oomlout/oomlout_oobb_part_motor_gearbox_cycloidal_version_5/releases/version_8/README.md

# Version 8 — sealed

Preserves both native 20:1 and compact 10:1 presets, the nine printed parts, three-piece casing, full-depth OOBB tabs, recessed socket-cap clamps and configurable guide screws/spacers.

The archive contains the source, both complete parts folders, populate metadata, navigation pointers and accepted CAD evidence (solidcraft/evidence/v8_three_piece.zip). Every archived file was verified by SHA-256. release.json also protects the frozen catalogue files in place. The master here is a frozen inspection copy; edit the root gearbox_controls.solidcraft or V9 variant masters for new work.

Six native configurations were checked; both presets have STEP/STL, native health, save/reopen, motion, sampling and hardware/access evidence. Existing acceptance policy is unchanged. Physical printing and load testing remain outstanding.
