oomlout/oomlout_oobb_part_motor_gearbox_cycloidal_version_5/parts/oobb_part_motor_gearbox_cycloidal_version_9_35_to_1_reduction/HARDWARE.md

# Hardware

| Item | Quantity |
|---|---:|
| 6808 bearing (40 × 52 × 7 mm) | 2 |
| 6702 bearing (15 × 21 × 4 mm) | 2 |
| 6701 bearing (12 × 18 × 4 mm) | 1 |
| M3 × 25 socket-cap guide screw + M3 nut | 6 |
| M3 × 25 socket-cap standoff screw + M3 nut | 3 |
| M3 × 20 socket-cap casing screw + M3 nut | 4 |
| M3 × 6 countersunk NEMA17 mounting screw | 4 |
| M3 × 4 socket-cap hub joining screw + M3 nut | 1 |
| M3 × 8 grub screw + M3 nut | 1 |
| M6 nuts for selected output mounting holes | Up to 12, optional |

Lengths are nominal under-head dimensions except countersunk screws, which include the head. The base grub screw is tightened before fitting the motor plate. The native exploded view shows printed parts; purchased hardware is listed here. Mounting screws for an attached OOBB structure depend on that structure. Physical fit/load testing remains necessary.
