oomlout/oomlout_oobb_part_motor_gearbox_cycloidal_version_5/cycloidal_explorer/dist/cycloidal-examples.pdf

OOBB / MECHANISM STUDIES | V05 / GEOMETRY LAB

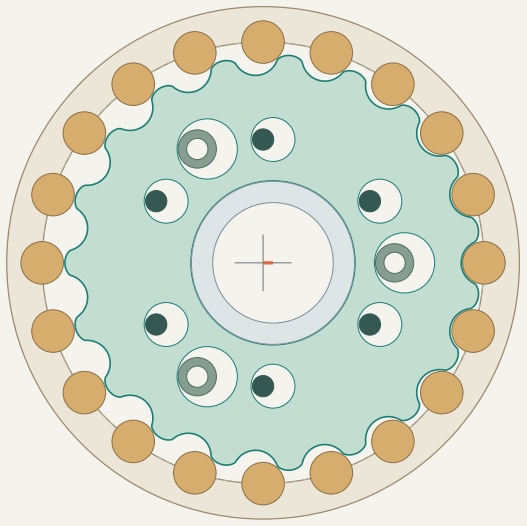
[picture p1: figure]

Cycloidal V5 | 26 October 2026 | Dimensions in mm | DESIGN STUDY / 01

# 20:1 / Current V5

The active 20:1 design: 3 mm printed contacts and 1.4 mm eccentricity.

6810

50 x 65 x 7 mm

Casing diameter 72.30 | Outside diameter 65.00

Bore diameter 50.00

Pitch diameter 62.30 | 19 disc lobes
Ring contacts / disc lobes / output direction | 20 / 19 / same as input
Pitch radius / contact radius / eccentricity | 31.15 / 3.00 / 1.40
Radial profile clearance / casing wall | 0.20 / 2.00
Disc root / tip diameter | 53.10 / 58.70
Disc swept envelope / casing diameter | 61.50 / 72.30
Guide holes (6) / guide pitch circle | 6.20 / 34.80
Standoff holes (3) / standoff pitch circle | 8.50 / 37.10
Disc thickness / gap / bearing-disc stack only | 5.00 / 0.50 / 24.50
Minimum convex radius / offset used | 3.213 / 3.200

8/8 screening checks pass

The explorer checks radial envelopes, undercut, contact attachment, orbit-hole webs, casing-lip passage and eccentric-bearing retention. Explorations are not full CAD-validated assemblies.

Current V5 reference: 32 mm overall height above the motor face; casing depth 26.6 mm; mounting plate 74 mm across. These heights are not extrapolated to changed designs.

50 mm check bar. Diagrams 1:1 on A4 at 100% / Actual size.

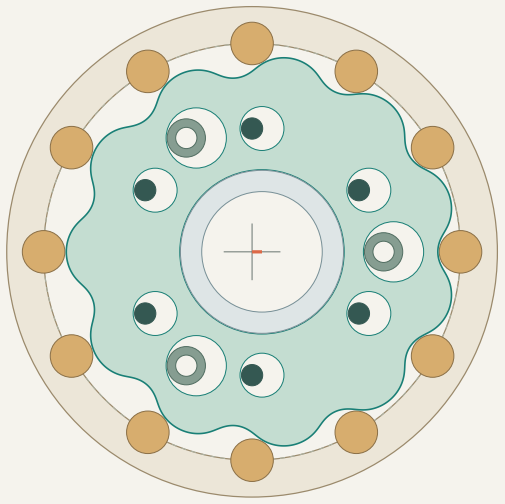
[picture p2: figure]

Cycloidal V5 | 26 October 2026 | Dimensions in mm | DESIGN STUDY / 02

# 12:1 / 12:1 exploration

Fewer, broader lobes with the same contacts and orbit. V5 radial interfaces retained.

6810

50 x 65 x 7 mm

Casing diameter 69.20 | Outside diameter 65.00

Bore diameter 50.00

Pitch diameter 58.80 | 11 disc lobes
Ring contacts / disc lobes / output direction | 12 / 11 / same as input
Pitch radius / contact radius / eccentricity | 29.40 / 3.00 / 1.40
Radial profile clearance / casing wall | 0.20 / 2.00
Disc root / tip diameter | 49.60 / 55.20
Disc swept envelope / casing diameter | 58.00 / 69.20
Guide holes (6) / guide pitch circle | 6.20 / 34.80
Standoff holes (3) / standoff pitch circle | 8.50 / 37.10
Disc thickness / gap / bearing-disc stack only | 5.00 / 0.50 / 24.50
Minimum convex radius / offset used | 8.871 / 3.200

8/8 screening checks pass

The explorer checks radial envelopes, undercut, contact attachment, orbit-hole webs, casing-lip passage and eccentric-bearing retention. Explorations are not full CAD-validated assemblies.

Retains the fixed V5 radial interfaces and 6810 end bearings. Recalculate the axial stack and run the native CAD, assembly and motion checks before making parts.

50 mm check bar. Diagrams 1:1 on A4 at 100% / Actual size.

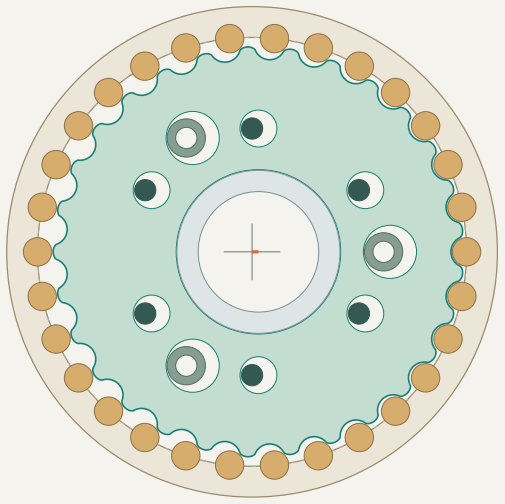
[picture p3: figure]

Cycloidal V5 | 26 October 2026 | Dimensions in mm | DESIGN STUDY / 03

# 30:1 / 30:1 exploration

A smaller orbit and 2 mm contacts keep the higher contact count compact.

6810

50 x 65 x 7 mm

Casing diameter 69.20 | Outside diameter 65.00

Bore diameter 50.00

Pitch diameter 60.50 | 29 disc lobes
Ring contacts / disc lobes / output direction | 30 / 29 / same as input
Pitch radius / contact radius / eccentricity | 30.25 / 2.00 / 0.90
Radial profile clearance / casing wall | 0.20 / 2.00
Disc root / tip diameter | 54.30 / 57.90
Disc swept envelope / casing diameter | 59.70 / 69.20
Guide holes (6) / guide pitch circle | 5.20 / 34.80
Standoff holes (3) / standoff pitch circle | 7.50 / 37.10
Disc thickness / gap / bearing-disc stack only | 5.00 / 0.50 / 24.50
Minimum convex radius / offset used | 2.211 / 2.200

8/8 screening checks pass

The explorer checks radial envelopes, undercut, contact attachment, orbit-hole webs, casing-lip passage and eccentric-bearing retention. Explorations are not full CAD-validated assemblies.

Retains the fixed V5 radial interfaces and 6810 end bearings. Recalculate the axial stack and run the native CAD, assembly and motion checks before making parts.

50 mm check bar. Diagrams 1:1 on A4 at 100% / Actual size.

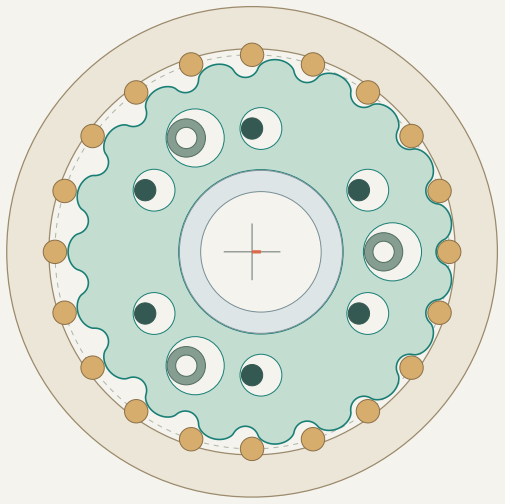
[picture p4: figure]

Cycloidal V5 | 26 October 2026 | Dimensions in mm | DESIGN STUDY / 04

# 20:1 / Smaller-contact study

A 20:1 study inspired by the earlier 1.65 mm contact / 1.25 mm orbit iterations.

6810

50 x 65 x 7 mm

Casing diameter 69.20 | Outside diameter 65.00

Bore diameter 50.00

Pitch diameter 55.60 | 19 disc lobes
Ring contacts / disc lobes / output direction | 20 / 19 / same as input
Pitch radius / contact radius / eccentricity | 27.80 / 1.65 / 1.25
Radial profile clearance / casing wall | 0.20 / 2.00
Disc root / tip diameter | 49.40 / 54.40
Disc swept envelope / casing diameter | 56.90 / 69.20
Guide holes (6) / guide pitch circle | 5.90 / 34.80
Standoff holes (3) / standoff pitch circle | 8.20 / 37.10
Disc thickness / gap / bearing-disc stack only | 5.00 / 0.50 / 24.50
Minimum convex radius / offset used | 2.862 / 1.850

8/8 screening checks pass

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

Retains the fixed V5 radial interfaces and 6810 end bearings. Recalculate the axial stack and run the native CAD, assembly and motion checks before making parts.

50 mm check bar. Diagrams 1:1 on A4 at 100% / Actual size.

Cycloidal V5 | 26 October 2026 | Dimensions in mm | PROJECT LESSONS / 05

# Why the old pitch failed

The project regression captures an important failure: increasing the contact radius without increasing the pitch radius creates an undercut profile.

Same inputs in both studies | 20 contacts / e 1.40 / r 3.00 / clearance 0.20
Old pitch radius / current pitch radius | 30.15 / 31.15
Old minimum convex radius | 2.631624
Required inward offset | 3.200000
Old undercut margin | -0.568376 - rejected
Current minimum convex radius | 3.212642
Current undercut margin | 0.012642 - passes

### 01 / The ratio belongs to the output member

The V5 discs are prevented from spinning by fixed guides. They orbit on opposed eccentrics while the casing rotates in the input direction. N contacts and N-1 disc lobes give N:1 casing reduction. A fixed-ring, rotating-disc arrangement has a different ratio and direction.

### 02 / Contact radius is not rotor radius

The adjustable lobe radius is the radius of each circular contact in the casing. Current contacts are solid printed features. A future M3 axle needs a 6 mm outside-diameter roller or sleeve to reproduce a 3 mm contact radius.

### 03 / Bearings occupy a different axial region

6810 means 50 mm bore, 65 mm outside diameter, 7 mm width. Two end bearings capture the casing. The disc plane lies between them. Guide holes are 3 + 2e + 0.40 mm; standoff holes are 5.4 + 2e + 0.30 mm. More eccentricity takes material out of both webs.

### 04 / Geometry is the first gate

A passing radial study does not establish load capacity, backlash, wear or print fit. The current underside needs slicer supports. Test the shared fit coupons and smooth guide surfaces, and run the full native CAD and motion validation for any changed design.

Source trace

Repository: README.md; working_oomp_populate.py; gearbox_native/cycloid_equation.py, captured.py, simple.py and interfaces.py; tests/test_native_three_mm_lobes.py. All four examples use the same geometry calculation as the HTML explorer.

Bearing reference: NSK 6810 product dimensions (50 x 65 x 7 mm). (https://www.nsk.com/engineering/products/bearings/ball-bearings/deep-groove-ball-bearings/single-row-deep-groove-ball-bearings/6810-apn.html)
