oomlout/oomlout_oobb_part_motor_gearbox_cycloidal_version_5/navigation_oobb/oobb/part/motor_gearbox/cycloidal/version_9/35_to_1_reduction/README.md

# Native V9 — 35:1

[Parts and editing instructions](../../../../../../../parts/oobb_part_motor_gearbox_cycloidal_version_9_35_to_1_reduction/README.md)
