oomlout/oomlout_oobb_part_motor_gearbox_cycloidal_version_5/releases/version_7/README.md

# Version 7 — sealed

Preserves the native parametric gearbox, 40 casing-bearing options and automatic odd OOBB mounting footprints. The current native master, assembled/exploded/print exports, source, shared helper component sources and accepted JSON verification records are in version_7.zip. Each archive entry is SHA-256 checked. See evidence_index.json for the archived verification paths. Historical inherited layouts and renders remain protected in the V7 catalogue and earlier releases.

The frozen master is in [the sealed V7 parts folder](../../parts/oobb_part_motor_gearbox_cycloidal_version_7_20_to_1_reduction/gearbox_controls.solidcraft). The project-root master continues as V8. No geometry or acceptance-policy changes were made. Twelve targeted tests passed. Physical printing/load testing remains outstanding.
