oomlout/oomlout_oobb_part_motor_gearbox_cycloidal_version_5/navigation_oobb/oobb/part/motor_gearbox/cycloidal/version_4/20_to_1_reduction/part_names.md

# Version 4 part names

| Name | File / hardware |
| --- | --- |
| Motor faceplate | motor_mount |
| Rear pin carrier | pin_rear |
| Front pin carrier | pin_front |
| Front bearing hub | front_bearing_hub |
| Output cover | output_cover |
| Disc A lower | rotor_a_lower |
| Disc A upper | rotor_a_upper |
| Disc B lower | rotor_b_lower |
| Disc B upper | rotor_b_upper |
| Output lobe ring | output_casing |
| Output casing base | output_base |
| Lower wiggle shaft | eccentric_hub_lower |
| Coupling drive plate | coupling_drive |
| Upper wiggle shaft | eccentric_hub_upper |
| Coupling nut collar | coupling_collar |
| Casing bearings | 2 x 6810 / 50 x 65 x 7 |
| Eccentric bearings | 2 x 6704 / 20 x 27 x 4 |
| Front shaft bearing | 6704 / 20 x 27 x 4 |
| Disc bearing rows | 12 x 6700 / 10 x 15 x 4 |
| Fixed guide bolts | 6 x M6 x 40 + nuts |
| Carrier spacers | 3 steel tubes / 6 OD x 3.2 ID x 15.5 |
| Disc screws | 6 x M3 x 6 countersunk + nuts |
| Hub joining bolt | M6 x 35 + captive M6 nut |
| Flange coupling | M5 bore / flange UP at 24 mm |
| Flange screws | 2 x M3 x 12 + side-loaded nuts |
| Motor screws | 4 x M3 x 6 countersunk |
| NEMA 17 motor | 5 mm shaft |
| Support fasteners | 3 x M3x25 rear; 3 x M3x25 posts; 3 x M3x16 hub |
| Casing screws | 4 x M3x35 socket caps; clamp cover / ring / base |
