oomlout/oomlout_oobb_part_motor_gearbox_cycloidal_version_5/parts/oobb_part_motor_gearbox_cycloidal_version_6_20_to_1_reduction_configuration_3d9262f6/solidcraft_renders/true/with_hardware/exploded_raw.png

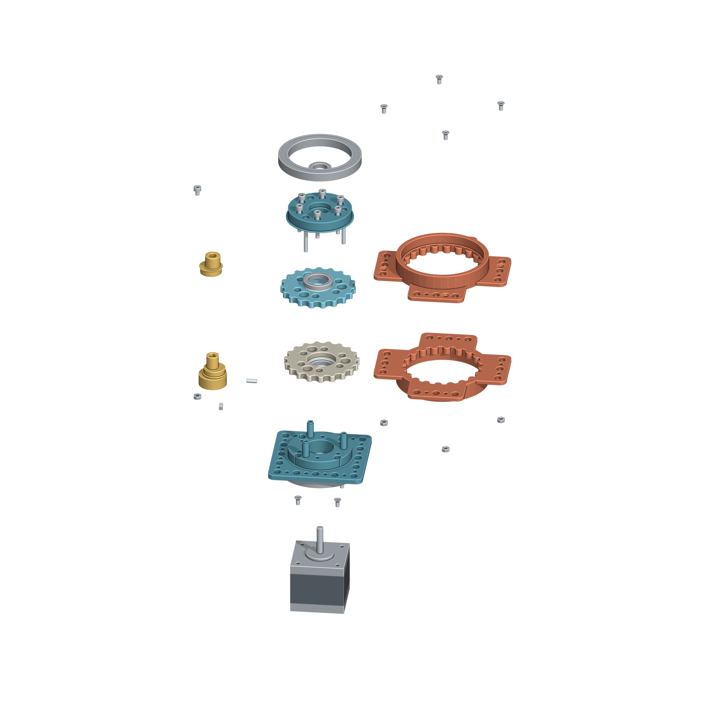
parts/oobb_part_motor_gearbox_cycloidal_version_6_20_to_1_reduction_configuration_3d9262f6/solidcraft_renders/true/with_hardware/exploded_raw.png
