oomlout/oomlout_oobb_part_motor_gearbox_cycloidal_version_5/parts/oobb_part_motor_gearbox_cycloidal_version_9_35_to_1_reduction/README.md

# Native V9 — 35:1

Edit [gearbox_controls.solidcraft](gearbox_controls.solidcraft) in SolidCraft's
Parameters menu. [Editing instructions](EDITING_PARAMETERS.md) explain the
controls and print orientations. This preset uses the same feature graph as
the other V9 presets, with exposed parameter overrides only.

| Dimension | Value |
|---|---:|
| Contact radius | 1.5 mm |
| Eccentricity | 0.7 mm |
| Casing bearing | 6808 |
| Minimum circular casing envelope | 62.8 mm |
| OOBB grid | 5 × 5 |
| Tab footprint | 74 × 74 mm |
| Guide screws | 6 × M3 × 25 mm |
| Casing joining screws | 4 × M3 socket cap × 20 mm |

[Assembled](true.solidcraft) · [Exploded](exploded.solidcraft) ·
[Print layout](3dpr.solidcraft) · [Print STL](3dpr.stl)

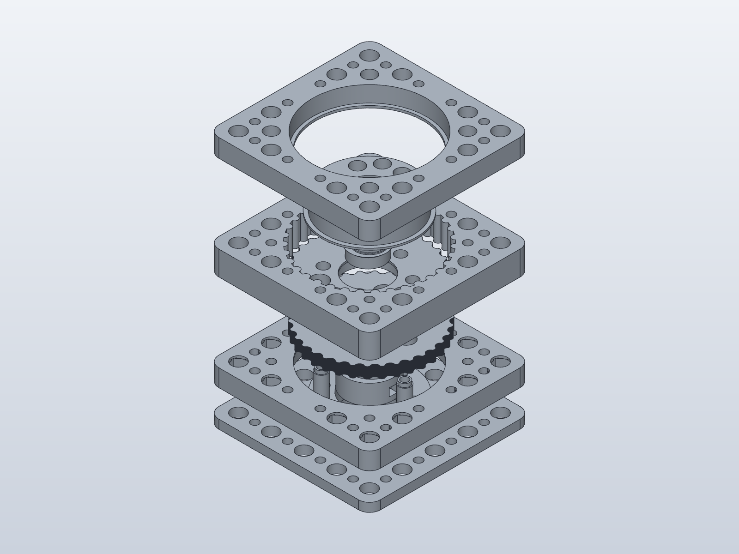
[picture p23: parts/oobb_part_motor_gearbox_cycloidal_version_9_35_to_1_reduction/exploded.png]
Exploded printed components


Individual print-oriented STEP/STL files are in `native_parts/`. The three
casing pieces print separately on their flat split/end faces. These view files
are independent snapshots. Native geometry and hardware clearance have been
checked; physical printing and load testing are still needed.

[Hardware for this published preset](HARDWARE.md)
