oomlout/oomlout_oobb_part_motor_gearbox_cycloidal_version_5/parts/oobb_part_motor_gearbox_cycloidal_version_7_20_to_1_reduction/README.md

# Native V7 snapshots

Start with [Editing the gearbox parameters](EDITING_PARAMETERS.md) for step-by-step instructions and generating assembled, exploded and print outputs from one master.

The working master is [../../gearbox_controls.solidcraft](../../gearbox_controls.solidcraft). Change its favourite parameters inside SolidCraft; no regeneration action is needed.

See [the parameter guide](../../NATIVE_V7.md) and [verification index](../../solidcraft/native_v7.json).

Local gearbox_controls.solidcraft, true.solidcraft, 3dpr.solidcraft and exploded.solidcraft are initial self-contained snapshots, not synchronized copies of the master. Individual current STEP/STL files are in native_parts/. The solidcraft/true and solidcraft/3dpr source documents and fits/ are inherited V6 evidence, not dependencies of the new master.
