oomlout/oomlout_oobb_part_motor_gearbox_cycloidal_version_5/parts/oobb_part_motor_gearbox_cycloidal_version_7_20_to_1_reduction/VERSION_7_DEVELOPMENT.md

See [the current V7 development record](../../VERSION_7_DEVELOPMENT.md).
