oomlout/oomlout_oobb_part_motor_gearbox_cycloidal_version_5/parts/oobb_part_motor_gearbox_cycloidal_version_6_16_to_1_reduction_configuration_805810a8/fits/3dpr/fit_6701_shaft.png

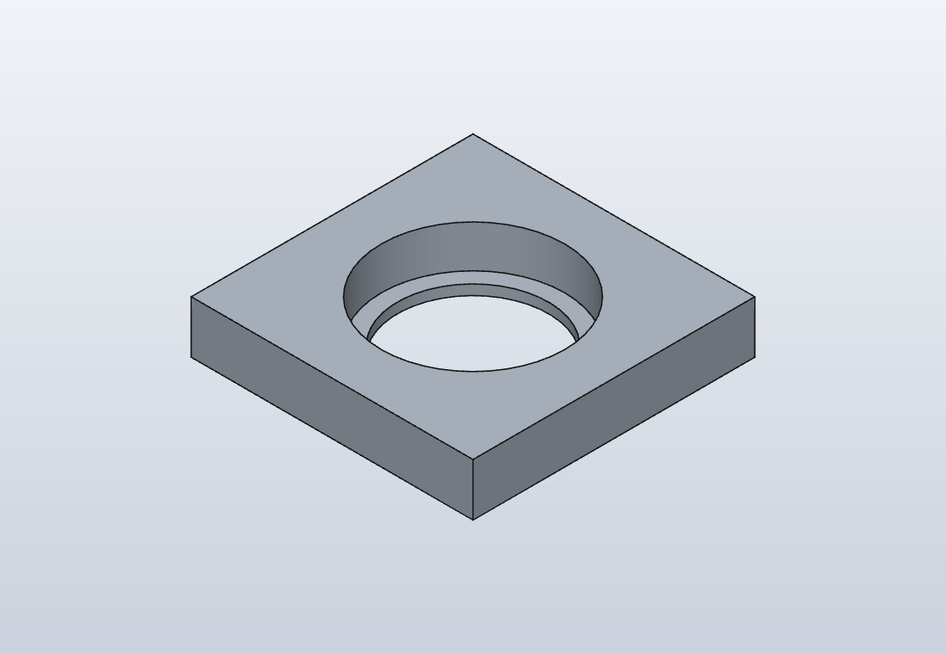
parts/oobb_part_motor_gearbox_cycloidal_version_6_16_to_1_reduction_configuration_805810a8/fits/3dpr/fit_6701_shaft.png
