oomlout/oomlout_oobb_part_motor_gearbox_cycloidal_version_5/parts/oobb_part_motor_gearbox_cycloidal_version_9_35_to_1_reduction/3dpr_solidcraft.png

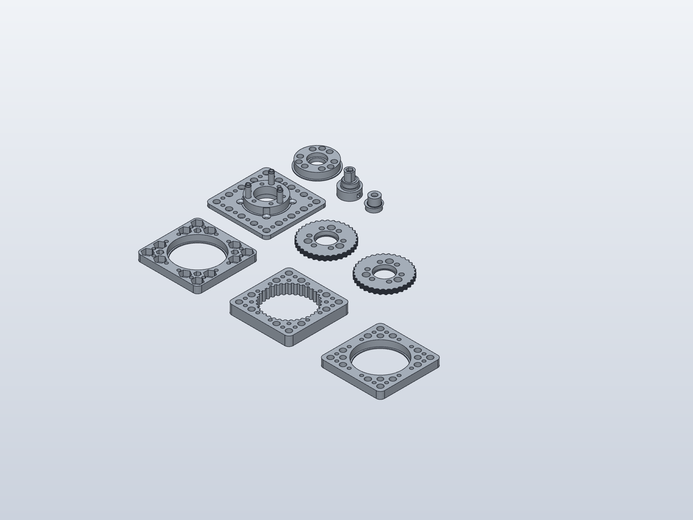
parts/oobb_part_motor_gearbox_cycloidal_version_9_35_to_1_reduction/3dpr_solidcraft.png
