oomlout/oomlout_oobb_part_motor_gearbox_cycloidal_version_5/parts/oobb_part_motor_gearbox_cycloidal_version_9_35_to_1_reduction/true.png

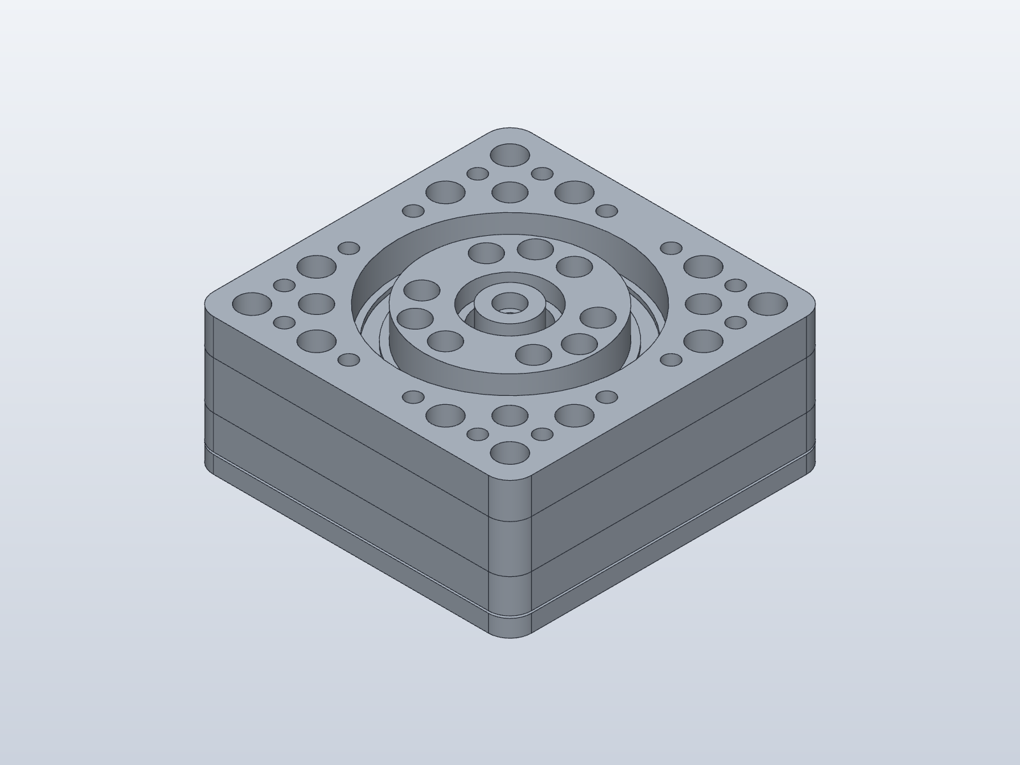
parts/oobb_part_motor_gearbox_cycloidal_version_9_35_to_1_reduction/true.png
