oomlout/oomlout_oobb_part_motor_gearbox_cycloidal_version_5/parts/oobb_part_motor_gearbox_cycloidal_version_6_16_to_1_reduction_configuration_805810a8/fits/3dpr/fit_6703_and_M3_orbit.step

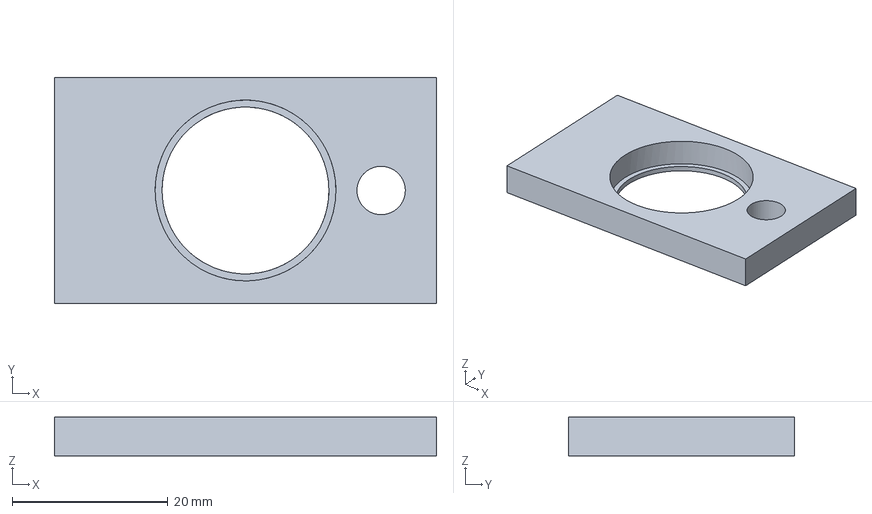
[picture p38: CAD file, 2026-10-28]
parts/oobb_part_motor_gearbox_cycloidal_version_6_16_to_1_reduction_configuration_805810a8/fits/3dpr/fit_6703_and_M3_orbit.step
49.0 x 29.0 x 5.00 mm
