oomlout/oomlout_oobb_part_motor_gearbox_cycloidal_version_5/parts/oobb_part_motor_gearbox_cycloidal_version_6_16_to_1_reduction_configuration_805810a8/solidcraft/3dpr/rotor_b.step

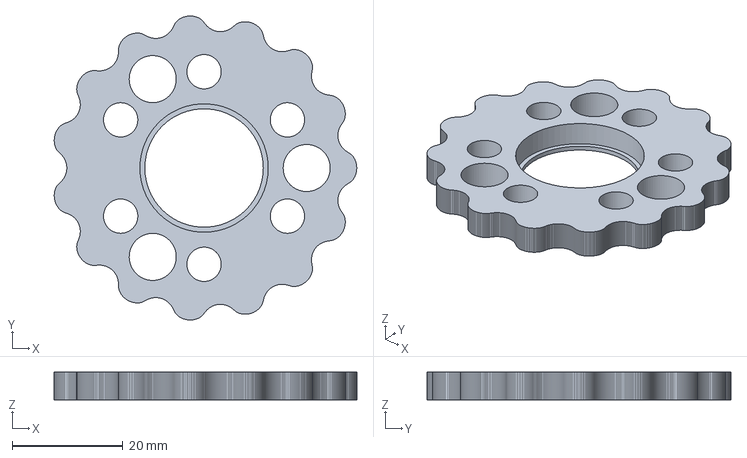
[picture p39: CAD file, 2026-10-28]
parts/oobb_part_motor_gearbox_cycloidal_version_6_16_to_1_reduction_configuration_805810a8/solidcraft/3dpr/rotor_b.step
54.7 x 54.9 x 5.00 mm
