oomlout/oomlout_oobb_part_motor_gearbox_cycloidal_version_5/parts/oobb_part_motor_gearbox_cycloidal_version_6_20_to_1_reduction_configuration_3d9262f6/fits/3dpr/fit_casing_clamp_lower.step

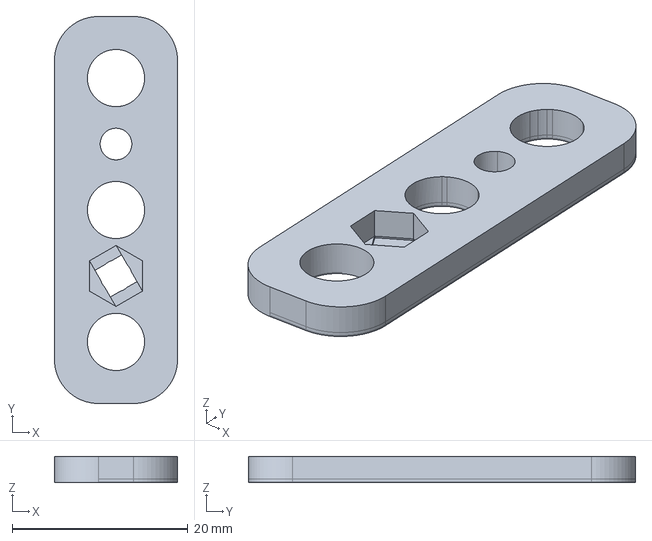
[picture p40: CAD file, 2026-10-28]
parts/oobb_part_motor_gearbox_cycloidal_version_6_20_to_1_reduction_configuration_3d9262f6/fits/3dpr/fit_casing_clamp_lower.step
14.0 x 44.0 x 3.00 mm
