oomlout/oomlout_oobb_part_motor_gearbox_cycloidal_version_5/parts/oobb_part_motor_gearbox_cycloidal_version_6_20_to_1_reduction_configuration_3d9262f6/solidcraft/3dpr/eccentric_hub_upper.step

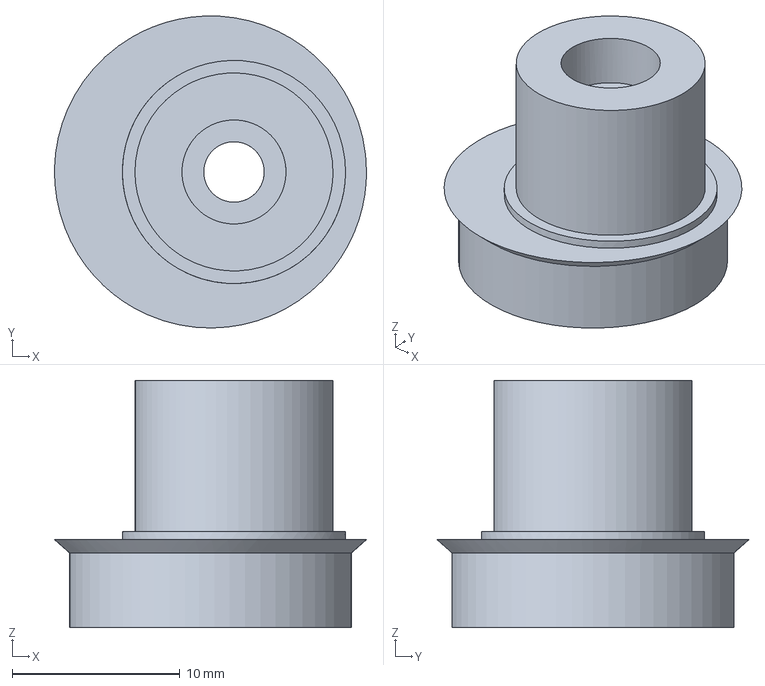
[picture p41: CAD file, 2026-10-28]
parts/oobb_part_motor_gearbox_cycloidal_version_6_20_to_1_reduction_configuration_3d9262f6/solidcraft/3dpr/eccentric_hub_upper.step
18.6 x 18.6 x 14.8 mm
