oomlout/oomlout_oobb_part_motor_gearbox_cycloidal_version_5/parts/oobb_part_motor_gearbox_cycloidal_version_6_20_to_1_reduction_configuration_3d9262f6/true_solidcraft.stl

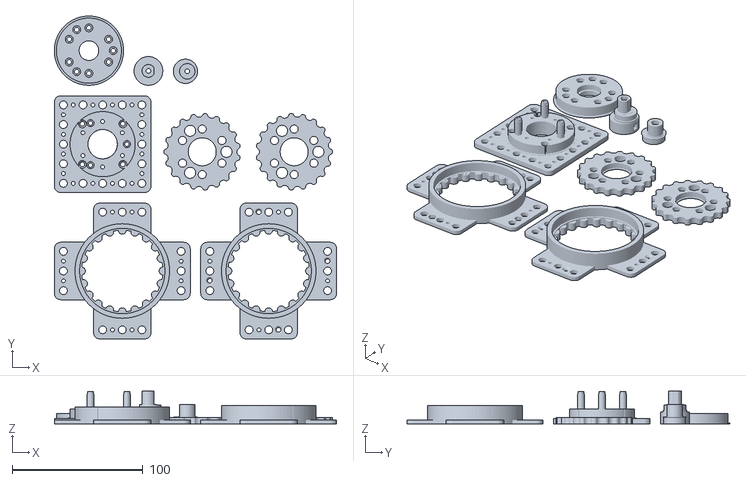
[picture p43: CAD file, 2026-10-28]
parts/oobb_part_motor_gearbox_cycloidal_version_6_20_to_1_reduction_configuration_3d9262f6/true_solidcraft.stl
216.0 x 247.0 x 25.0
