oomlout/oomlout_oobb_part_motor_gearbox_cycloidal_version_5/parts/oobb_part_motor_gearbox_cycloidal_version_6_20_to_1_reduction_configuration_cf886c08/inherited_reference_NOT_CURRENT/true/output_casing_upper.step

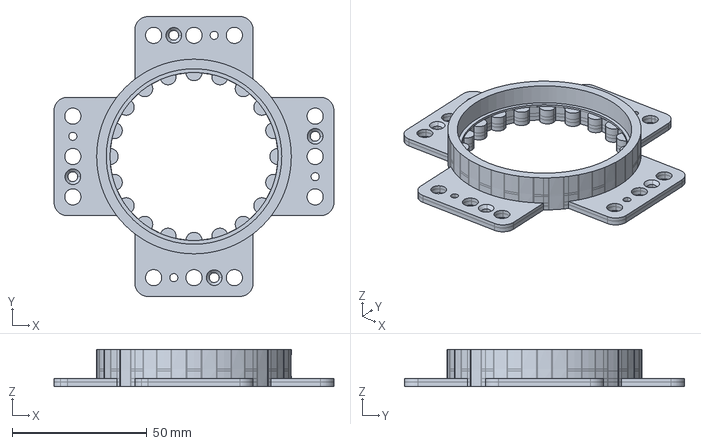
[picture p45: CAD file, 2026-10-28]
parts/oobb_part_motor_gearbox_cycloidal_version_6_20_to_1_reduction_configuration_cf886c08/inherited_reference_NOT_CURRENT/true/output_casing_upper.step
104.0 x 104.0 x 13.9 mm
