oomlout/oomlout_oobb_part_motor_gearbox_cycloidal_version_5/parts/oobb_part_motor_gearbox_cycloidal_version_9_35_to_1_reduction/native_parts/pin_front.step

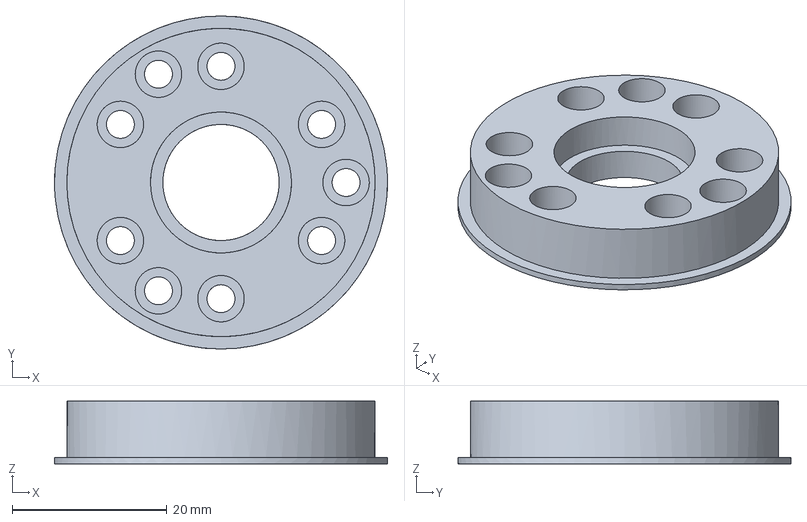
[picture p46: CAD file, 2026-10-29]
parts/oobb_part_motor_gearbox_cycloidal_version_9_35_to_1_reduction/native_parts/pin_front.step
43.0 x 43.0 x 8.10 mm
