oomlout/oomlout_oobb_part_motor_gearbox_cycloidal_version_5/parts/oobb_part_motor_gearbox_cycloidal_version_6_20_to_1_reduction_configuration_3d9262f6/fits/3dpr/fit_M3_standoff_lower.step

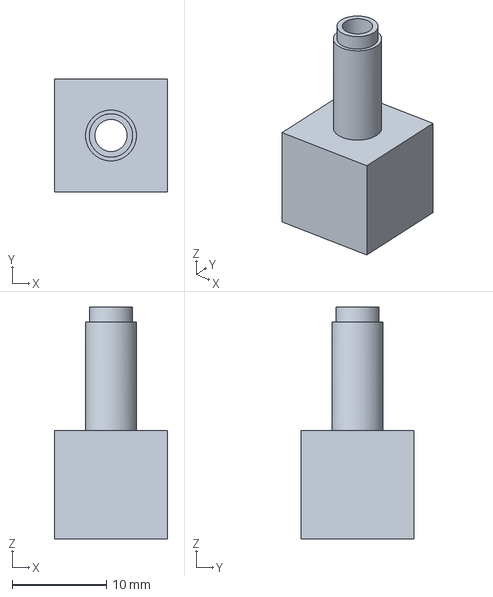
[picture p48: CAD file, 2026-10-28]
parts/oobb_part_motor_gearbox_cycloidal_version_6_20_to_1_reduction_configuration_3d9262f6/fits/3dpr/fit_M3_standoff_lower.step
12.0 x 12.0 x 24.6 mm
