oomlout/oomlout_oobb_part_motor_gearbox_cycloidal_version_5/parts/oobb_part_motor_gearbox_cycloidal_version_6_20_to_1_reduction_configuration_cf886c08/inherited_reference_NOT_CURRENT/true/eccentric_hub_lower.step

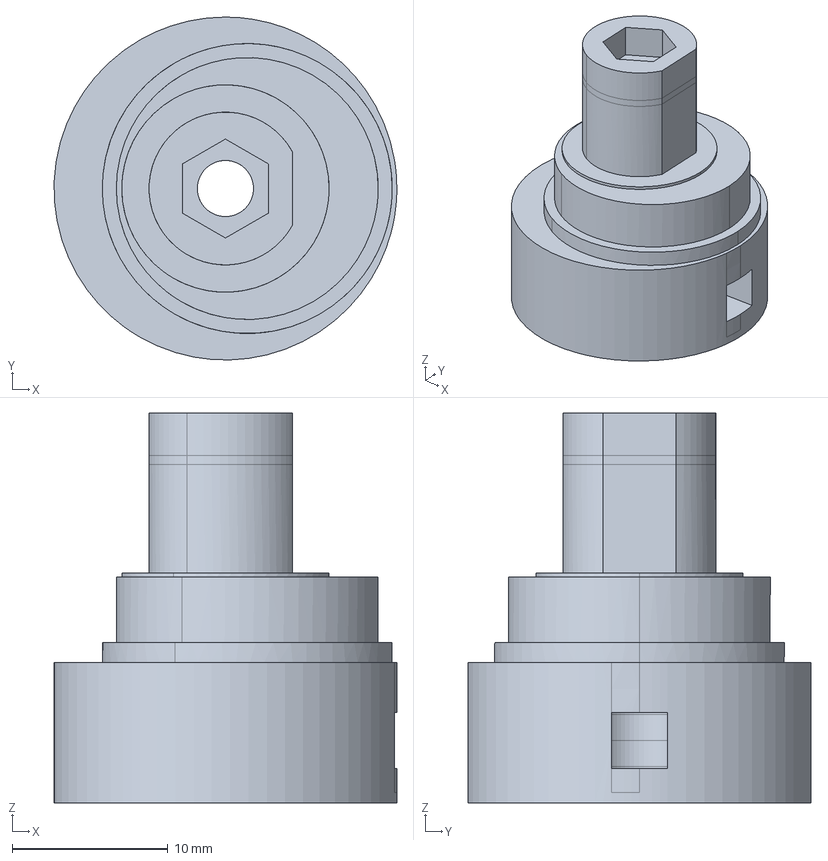
[picture p51: CAD file, 2026-10-28]
parts/oobb_part_motor_gearbox_cycloidal_version_6_20_to_1_reduction_configuration_cf886c08/inherited_reference_NOT_CURRENT/true/eccentric_hub_lower.step
22.0 x 22.0 x 25.0 mm
