oomlout/oomlout_oobb_part_motor_gearbox_cycloidal_version_5/parts/oobb_part_motor_gearbox_cycloidal_version_9_35_to_1_reduction/3dpr_solidcraft.stl

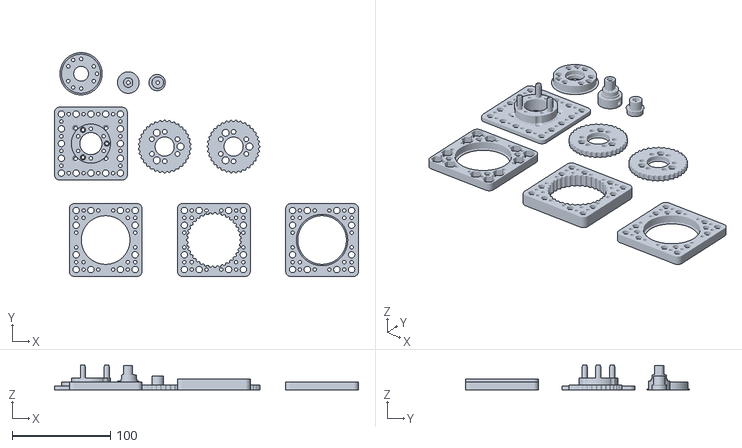
[picture p52: CAD file, 2026-10-29]
parts/oobb_part_motor_gearbox_cycloidal_version_9_35_to_1_reduction/3dpr_solidcraft.stl
309.0 x 227.5 x 25.3
