oomlout/oomlout_oobb_part_motor_gearbox_cycloidal_version_5/parts/oobb_part_motor_gearbox_cycloidal_version_6_20_to_1_reduction_configuration_3d9262f6/fits/3dpr/fit_M3_grub_and_5mm_shaft.step

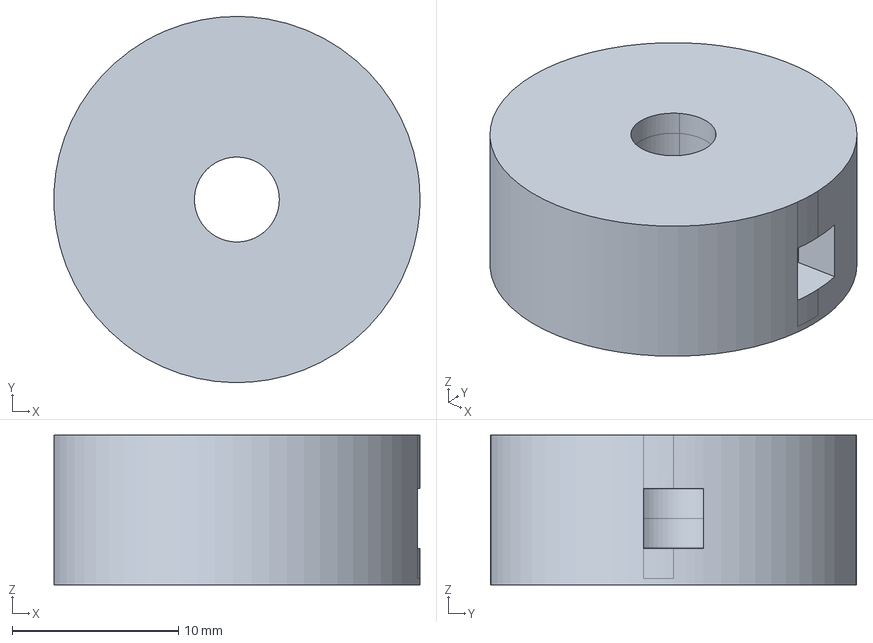
[picture p55: CAD file, 2026-10-28]
parts/oobb_part_motor_gearbox_cycloidal_version_6_20_to_1_reduction_configuration_3d9262f6/fits/3dpr/fit_M3_grub_and_5mm_shaft.step
22.0 x 22.0 x 9.00 mm
