oomlout/oomlout_oobb_part_motor_gearbox_cycloidal_version_5/parts/oobb_part_motor_gearbox_cycloidal_version_9_35_to_1_reduction/exploded_solidcraft.stl

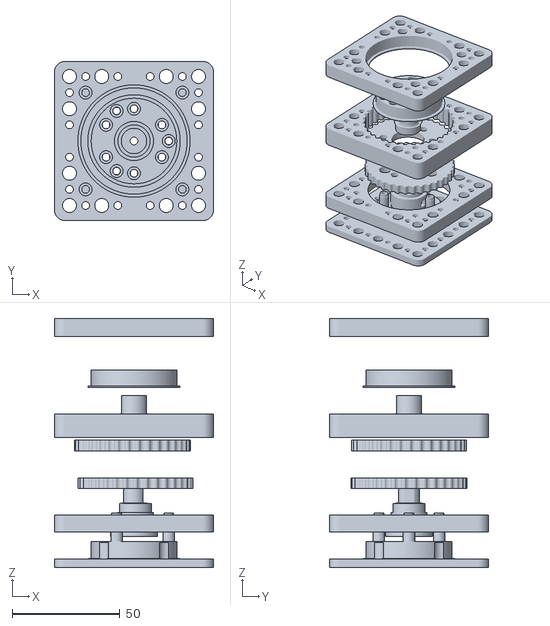
[picture p57: CAD file, 2026-10-29]
parts/oobb_part_motor_gearbox_cycloidal_version_9_35_to_1_reduction/exploded_solidcraft.stl
74.0 x 74.0 x 115.8
