oomlout/oomlout_oobb_part_motor_gearbox_cycloidal_version_5/parts/oobb_part_motor_gearbox_cycloidal_version_9_35_to_1_reduction/native_parts/rotor_a.step

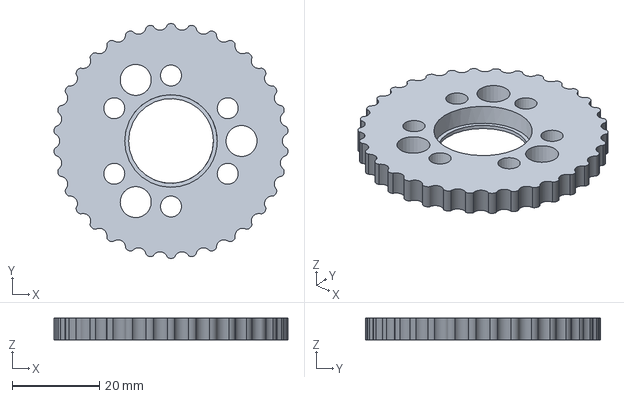
[picture p58: CAD file, 2026-10-29]
parts/oobb_part_motor_gearbox_cycloidal_version_9_35_to_1_reduction/native_parts/rotor_a.step
53.6 x 53.8 x 5.00 mm
