oomlout/oomlout_oobb_part_motor_gearbox_cycloidal_version_5/parts/oobb_part_motor_gearbox_cycloidal_version_9_35_to_1_reduction/native_parts/output_casing_upper.step

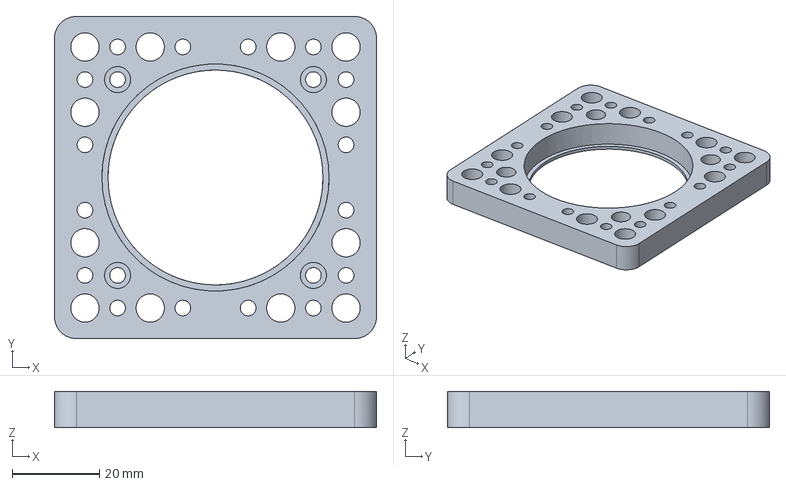
[picture p64: CAD file, 2026-10-29]
parts/oobb_part_motor_gearbox_cycloidal_version_9_35_to_1_reduction/native_parts/output_casing_upper.step
74.0 x 74.0 x 8.30 mm
