oomlout/oomlout_oobb_part_motor_gearbox_cycloidal_version_5/parts/oobb_part_motor_gearbox_cycloidal_version_9_35_to_1_reduction/true.step

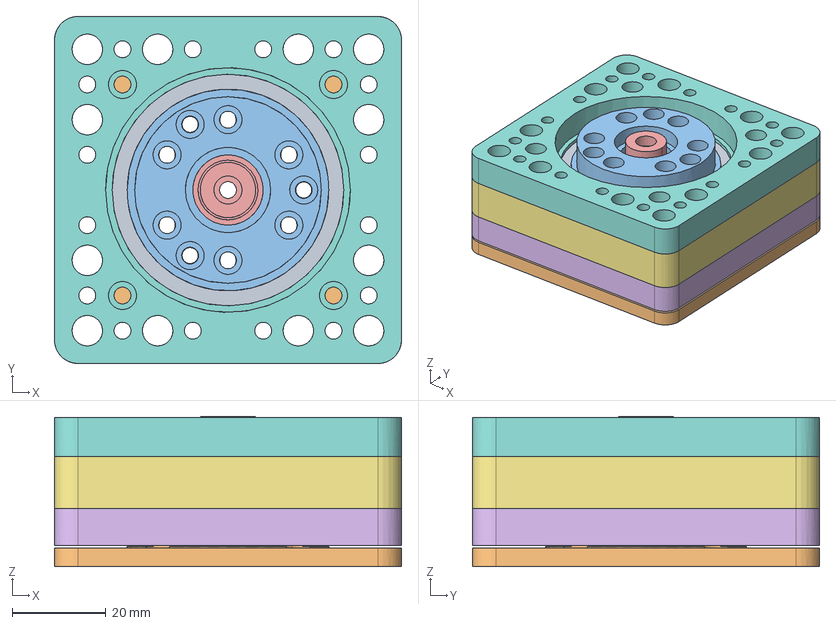
[picture p65: CAD file, 2026-10-29]
parts/oobb_part_motor_gearbox_cycloidal_version_9_35_to_1_reduction/true.step
74.0 x 74.0 x 32.0 mm
rotor_a
rotor_b
motor_mount
pin_front
eccentric_hub_lower
eccentric_hub_upper
output_casing_lower
output_casing_lobes
output_casing_upper
