oomlout/oomlout_oobb_part_motor_gearbox_cycloidal_version_5/(list of files, cad)

Other CAD files:
parts/oobb_part_motor_gearbox_cycloidal_version_9_35_to_1_reduction/3dpr.step
parts/oobb_part_motor_gearbox_cycloidal_version_6_16_to_1_reduction_configuration_805810a8/solidcraft/true/rotor_a.step
parts/oobb_part_motor_gearbox_cycloidal_version_6_20_to_1_reduction_configuration_3d9262f6/3dpr.step
parts/oobb_part_motor_gearbox_cycloidal_version_6_20_to_1_reduction_configuration_3d9262f6/solidcraft/true/output_casing_lower.step
parts/oobb_part_motor_gearbox_cycloidal_version_6_20_to_1_reduction_configuration_cf886c08/inherited_reference_NOT_CURRENT/3dpr/pin_front.step
parts/oobb_part_motor_gearbox_cycloidal_version_6_16_to_1_reduction_configuration_805810a8/solidcraft/3dpr/pin_front.step
parts/oobb_part_motor_gearbox_cycloidal_version_6_16_to_1_reduction_configuration_805810a8/solidcraft/true/motor_mount.step
parts/oobb_part_motor_gearbox_cycloidal_version_6_20_to_1_reduction_configuration_3d9262f6/3dpr_solidcraft.stl
parts/oobb_part_motor_gearbox_cycloidal_version_6_20_to_1_reduction_configuration_3d9262f6/solidcraft/3dpr/pin_front.step
parts/oobb_part_motor_gearbox_cycloidal_version_6_20_to_1_reduction_configuration_cf886c08/inherited_reference_NOT_CURRENT/3dpr/output_casing_upper.step
parts/oobb_part_motor_gearbox_cycloidal_version_6_20_to_1_reduction_configuration_3d9262f6/true.step
parts/oobb_part_motor_gearbox_cycloidal_version_6_20_to_1_reduction_configuration_cf886c08/inherited_reference_NOT_CURRENT/true/rotor_b.step
parts/oobb_part_motor_gearbox_cycloidal_version_9_35_to_1_reduction/exploded.step
parts/oobb_part_motor_gearbox_cycloidal_version_6_16_to_1_reduction_configuration_805810a8/solidcraft/3dpr/rotor_a.step
parts/oobb_part_motor_gearbox_cycloidal_version_6_20_to_1_reduction_configuration_3d9262f6/solidcraft/3dpr/output_casing_upper.step
parts/oobb_part_motor_gearbox_cycloidal_version_6_20_to_1_reduction_configuration_3d9262f6/solidcraft/true/rotor_b.step
parts/oobb_part_motor_gearbox_cycloidal_version_6_20_to_1_reduction_configuration_cf886c08/inherited_reference_NOT_CURRENT/true/output_casing_lower.step
parts/oobb_part_motor_gearbox_cycloidal_version_9_35_to_1_reduction/native_parts/eccentric_hub_lower.step
parts/oobb_part_motor_gearbox_cycloidal_version_9_35_to_1_reduction/true_solidcraft.stl
parts/oobb_part_motor_gearbox_cycloidal_version_6_16_to_1_reduction_configuration_805810a8/solidcraft/true/output_casing_lower.step
parts/oobb_part_motor_gearbox_cycloidal_version_6_20_to_1_reduction_configuration_3d9262f6/fits/3dpr/fit_casing_clamp_upper.step
parts/oobb_part_motor_gearbox_cycloidal_version_6_20_to_1_reduction_configuration_3d9262f6/solidcraft/3dpr/rotor_b.step
parts/oobb_part_motor_gearbox_cycloidal_version_6_20_to_1_reduction_configuration_3d9262f6/solidcraft/true/motor_mount.step
parts/oobb_part_motor_gearbox_cycloidal_version_6_16_to_1_reduction_configuration_805810a8/solidcraft/3dpr/output_casing_upper.step
parts/oobb_part_motor_gearbox_cycloidal_version_6_16_to_1_reduction_configuration_805810a8/solidcraft/true/output_casing_upper.step
parts/oobb_part_motor_gearbox_cycloidal_version_6_20_to_1_reduction_configuration_cf886c08/inherited_reference_NOT_CURRENT/3dpr/rotor_b.step
parts/oobb_part_motor_gearbox_cycloidal_version_6_20_to_1_reduction_configuration_cf886c08/inherited_reference_NOT_CURRENT/true/motor_mount.step
parts/oobb_part_motor_gearbox_cycloidal_version_9_35_to_1_reduction/native_parts/rotor_b.step
parts/oobb_part_motor_gearbox_cycloidal_version_6_16_to_1_reduction_configuration_805810a8/fits/3dpr/fit_casing_clamp_upper.step
parts/oobb_part_motor_gearbox_cycloidal_version_1_12_to_1_reduction/hardware_bearing_input.scad
parts/oobb_part_motor_gearbox_cycloidal_version_1_12_to_1_reduction/hardware_bearing_output.scad
parts/oobb_part_motor_gearbox_cycloidal_version_1_12_to_1_reduction/hardware_fasteners.scad
parts/oobb_part_motor_gearbox_cycloidal_version_1_12_to_1_reduction/hardware_retainer_screw.scad
navigation_oobb/oobb/part/motor_gearbox/cycloidal/version_1/12_to_1_reduction/3dpr.scad
navigation_oobb/oobb/part/motor_gearbox/cycloidal/version_1/12_to_1_reduction/3dpr.stl
navigation_oobb/oobb/part/motor_gearbox/cycloidal/version_1/12_to_1_reduction/animation.scad
navigation_oobb/oobb/part/motor_gearbox/cycloidal/version_1/12_to_1_reduction/assembly.scad
navigation_oobb/oobb/part/motor_gearbox/cycloidal/version_1/12_to_1_reduction/bearing_retainer_back.scad
navigation_oobb/oobb/part/motor_gearbox/cycloidal/version_1/12_to_1_reduction/bearing_retainer_back.stl
navigation_oobb/oobb/part/motor_gearbox/cycloidal/version_1/12_to_1_reduction/bearing_retainer_front.scad
navigation_oobb/oobb/part/motor_gearbox/cycloidal/version_1/12_to_1_reduction/bearing_retainer_front.stl
navigation_oobb/oobb/part/motor_gearbox/cycloidal/version_1/12_to_1_reduction/eccentric_lower.scad
navigation_oobb/oobb/part/motor_gearbox/cycloidal/version_1/12_to_1_reduction/eccentric_lower.stl
navigation_oobb/oobb/part/motor_gearbox/cycloidal/version_1/12_to_1_reduction/eccentric_upper.scad
navigation_oobb/oobb/part/motor_gearbox/cycloidal/version_1/12_to_1_reduction/eccentric_upper.stl
navigation_oobb/oobb/part/motor_gearbox/cycloidal/version_1/12_to_1_reduction/exploded.scad
navigation_oobb/oobb/part/motor_gearbox/cycloidal/version_1/12_to_1_reduction/fit_check.scad
navigation_oobb/oobb/part/motor_gearbox/cycloidal/version_1/12_to_1_reduction/fit_coupon.scad
navigation_oobb/oobb/part/motor_gearbox/cycloidal/version_1/12_to_1_reduction/fit_coupon.stl
navigation_oobb/oobb/part/motor_gearbox/cycloidal/version_1/12_to_1_reduction/hardware_bearing_input.scad
navigation_oobb/oobb/part/motor_gearbox/cycloidal/version_1/12_to_1_reduction/hardware_bearing_output.scad
navigation_oobb/oobb/part/motor_gearbox/cycloidal/version_1/12_to_1_reduction/hardware_fasteners.scad
navigation_oobb/oobb/part/motor_gearbox/cycloidal/version_1/12_to_1_reduction/hardware_retainer_screw.scad
navigation_oobb/oobb/part/motor_gearbox/cycloidal/version_1/12_to_1_reduction/housing_back.scad
navigation_oobb/oobb/part/motor_gearbox/cycloidal/version_1/12_to_1_reduction/housing_back.stl
navigation_oobb/oobb/part/motor_gearbox/cycloidal/version_1/12_to_1_reduction/housing_front.scad
navigation_oobb/oobb/part/motor_gearbox/cycloidal/version_1/12_to_1_reduction/housing_front.stl
navigation_oobb/oobb/part/motor_gearbox/cycloidal/version_1/12_to_1_reduction/housing_spacer.scad
navigation_oobb/oobb/part/motor_gearbox/cycloidal/version_1/12_to_1_reduction/housing_spacer.stl
navigation_oobb/oobb/part/motor_gearbox/cycloidal/version_1/12_to_1_reduction/input_hub_lower.scad
navigation_oobb/oobb/part/motor_gearbox/cycloidal/version_1/12_to_1_reduction/input_hub_lower.stl
navigation_oobb/oobb/part/motor_gearbox/cycloidal/version_1/12_to_1_reduction/input_hub_upper.scad
navigation_oobb/oobb/part/motor_gearbox/cycloidal/version_1/12_to_1_reduction/input_hub_upper.stl
navigation_oobb/oobb/part/motor_gearbox/cycloidal/version_1/12_to_1_reduction/input_shaft_spacer.scad
navigation_oobb/oobb/part/motor_gearbox/cycloidal/version_1/12_to_1_reduction/input_shaft_spacer.stl
navigation_oobb/oobb/part/motor_gearbox/cycloidal/version_1/12_to_1_reduction/output_carrier_lower.scad
navigation_oobb/oobb/part/motor_gearbox/cycloidal/version_1/12_to_1_reduction/output_carrier_lower.stl
navigation_oobb/oobb/part/motor_gearbox/cycloidal/version_1/12_to_1_reduction/output_carrier_upper.scad
navigation_oobb/oobb/part/motor_gearbox/cycloidal/version_1/12_to_1_reduction/output_carrier_upper.stl
navigation_oobb/oobb/part/motor_gearbox/cycloidal/version_1/12_to_1_reduction/rotor_lower.scad
navigation_oobb/oobb/part/motor_gearbox/cycloidal/version_1/12_to_1_reduction/rotor_lower.stl
navigation_oobb/oobb/part/motor_gearbox/cycloidal/version_1/12_to_1_reduction/rotor_upper.scad
navigation_oobb/oobb/part/motor_gearbox/cycloidal/version_1/12_to_1_reduction/rotor_upper.stl
navigation_oobb/oobb/part/motor_gearbox/cycloidal/version_1/12_to_1_reduction/section.scad
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
