oomlout/oomlout_oobb_part_motor_gearbox_cycloidal_version_5/solidcraft/evidence/v8_targeted_tests.txt

regression
..........                                                               [100%]
10 passed in 19.22s

published_artifacts
...........                                                              [100%]
11 passed in 1.05s

shared_helper
..                                                                       [100%]
2 passed in 2.16s
