oomlout/oomlout_oobb_part_motor_gearbox_cycloidal_version_5/releases/version_5/evidence/14a2068fecc2/features/failure.txt

Traceback (most recent call last):
  File "C:\gh\oomlout_oobb_part_motor_gearbox_cycloidal_version_5\gearbox_native\export.py", line 64, in render_piece
    outcome=render_thing(local,plan=plan,output_dir=folder,export_stl=True,
            ^^^^^^^^^^^^^^^^^^^^^^^^^^^^^^^^^^^^^^^^^^^^^^^^^^^^^^^^^^^^^^^
  File "C:\od\OneDrive\docs\software_cad_mcp_helper\components\backend\working.py", line 132, in render_thing
    original = check_health(client, output / "native_inspection.json")
               ^^^^^^^^^^^^^^^^^^^^^^^^^^^^^^^^^^^^^^^^^^^^^^^^^^^^^^^
  File "C:\gh\oomlout_oobb_part_motor_gearbox_cycloidal_version_5\gearbox_native\acceptance.py", line 84, in health_check
    raise ValueError(f'Unconstrained sketch: {sketch}')
ValueError: Unconstrained sketch: {'constraints': [{'c': 0, 'expression': '2 * oobb_hole_radius_2d55_radius', 'id': 'k1', 'name': 'DiameterDimension', 'param': 'd64', 'type': 'diameter', 'value': 5.1}], 'curves': [{'center': 'c1.center', 'center_at': [0.0, 0.0], 'construction': False, 'fixed': False, 'fully_constrained': False, 'id': 'c1', 'radius': 2.55, 'type': 'circle'}], 'dof': 2, 'failing': [], 'fully_constrained': False, 'id': 28, 'links': [], 'name': 'oobb_hole_radius_2d55_positions', 'plane': {'origin': [0.0, 0.0, -0.01], 'x_dir': [1.0, 0.0, 0.0], 'y_dir': [0.0, 1.0, 0.0]}, 'points': [{'at': [0.0, 0.0], 'fixed': True, 'fully_constrained': True, 'id': 'origin', 'link': None, 'world': [0.0, 0.0, -0.01]}, {'at': [0.0, 0.0], 'fixed': False, 'fully_constrained': False, 'id': 'c1.center', 'link': None, 'world': [0.0, 0.0, -0.01]}], 'profiles': [{'area_mm2': 20.42820622996763, 'centroid_sketch': [-1.6675024082500703e-16, -9.113489724437376e-17], 'curves': ['c1'], 'holes': [], 'index': 0}], 'status': 'solved', 'visible': False, 'wires': []}
