oomlout/oomlout_oobb_part_motor_gearbox_cycloidal_version_5/parts/oobb_part_motor_gearbox_cycloidal_version_9_35_to_1_reduction/working.yaml

architecture: simple_6810
automatic_pitch: 1
bearing_eccentric_bottom: '6702'
bearing_eccentric_top: '6702'
bip_39_2_word_array:
- economy
- forward
bip_39_2_word_no_space: economyforward
bip_39_2_word_space: economy forward
bip_39_2_word_underscore: economy_forward
bip_39_3_word_array:
- economy
- forward
- garage
bip_39_3_word_no_space: economyforwardgarage
bip_39_3_word_space: economy forward garage
bip_39_3_word_underscore: economy_forward_garage
bip_39_full_array:
- economy
- forward
- garage
- tourist
- outdoor
- parade
- seek
- engage
- gaze
- oven
- eternal
- budget
bip_39_full_no_space: economyforwardgaragetouristoutdoorparadeseekengagegazeoveneternalbudget
bip_39_full_space: economy forward garage tourist outdoor parade seek engage gaze
    oven eternal budget
bip_39_full_underscore: economy_forward_garage_tourist_outdoor_parade_seek_engage_gaze_oven_eternal_budget
casing_wall: 2.0
direct_stack_layout: base_grub
directory: parts/oobb_part_motor_gearbox_cycloidal_version_9_35_to_1_reduction
disc_gap: 0.5
drive_connection: grub_nut
guide_bolt_radius_name: m3
guide_pin_count: 6
guide_pin_diameter: 3.0
guide_pin_pitch_radius: 15.0
id: oobb_part_motor_gearbox_cycloidal_version_9_35_to_1_reduction
id_no_class: oobb_part_motor_gearbox_cycloidal_version_9_35_to_1_reduction
id_no_size: oobb_part_motor_gearbox_cycloidal_version_9_35_to_1_reduction
id_no_type: oobb_part_motor_gearbox_cycloidal_version_9_35_to_1_reduction
link_github: https://github.com/oomlout/oomlout_oomp_version_1_messy/tree/main/parts/oobb_part_motor_gearbox_cycloidal_version_9_35_to_1_reduction
link_main: https://github.com/oomlout/oomlout_oomp_version_1_messy/tree/main/parts/oobb_part_motor_gearbox_cycloidal_version_9_35_to_1_reduction
link_redirect: https://github.com/oomlout/oomlout_oomp_version_1_messy/tree/main/parts/oobb_part_motor_gearbox_cycloidal_version_9_35_to_1_reduction
lobe_clearance: 0.2
lobe_eccentricity_ratio: 0.9
lobe_radius: 1.5
md5: 462b797df2f9d34030c25260b3b9360e
md5_10: 462b797df2
md5_10_upper: 462B797DF2
md5_5: 462b7
md5_5_upper: 462B7
md5_6: 462b79
md5_6_alpha: 2qkc9
md5_6_alpha_upper: 2QKC9
md5_6_upper: 462B79
motor_hole_pitch: 31
motor_screw_length: 6
name: Oobb Part Motor Gearbox Cycloidal Version 9 35 To 1 Reduction
name_no_class: Oobb Part Motor Gearbox Cycloidal Version 9 35 To 1 Reduction
name_no_size: Oobb Part Motor Gearbox Cycloidal Version 9 35 To 1 Reduction
name_no_type: Oobb Part Motor Gearbox Cycloidal Version 9 35 To 1 Reduction
name_proper: Oobb Part Motor Gearbox Cycloidal Version 9 35 To 1 Reduction
name_space: oobb part motor gearbox cycloidal version 9 35 to 1 reduction
name_upper: OOBB PART MOTOR GEARBOX CYCLOIDAL VERSION 9 35 TO 1 REDUCTION
native_parameters:
    automatic_internal_positions: '1'
    bottom_bearing: '6702'
    casing_bearing: '6808'
    contact_radius: 1.5 mm
    eccentricity: 0.7 mm
    guide_count: '6'
    guide_outer_radius: 1.5 mm
    guide_radius: 1.5 mm
    guide_screw_length: 25 mm
    reduction: '35'
    standoff_radius: 2.7 mm
    top_bearing: '6702'
oobb_details:
    architecture: simple_6810
    automatic_pitch: 1
    bearing_eccentric_bottom: '6702'
    bearing_eccentric_top: '6702'
    casing_wall: 2.0
    direct_stack_layout: base_grub
    disc_gap: 0.5
    drive_connection: grub_nut
    guide_bolt_radius_name: m3
    guide_pin_count: 6
    guide_pin_diameter: 3.0
    guide_pin_pitch_radius: 15.0
    lobe_clearance: 0.2
    lobe_eccentricity_ratio: 0.9
    lobe_radius: 1.5
    motor_hole_pitch: 31
    motor_screw_length: 6
    native_parameters:
        automatic_internal_positions: '1'
        bottom_bearing: '6702'
        casing_bearing: '6808'
        contact_radius: 1.5 mm
        eccentricity: 0.7 mm
        guide_count: '6'
        guide_outer_radius: 1.5 mm
        guide_radius: 1.5 mm
        guide_screw_length: 25 mm
        reduction: '35'
        standoff_radius: 2.7 mm
        top_bearing: '6702'
    oobb_name: version_9
    oobb_type: cycloidal
    pitch_radius: 27.9
    pitch_radius_buffer: 0.0
    pitch_radius_increment: 0.05
    post_fasteners: true
    post_pitch_radius: 16.15
    post_radius: 2.7
    radius_offset: 0.7
    reduction: 35
    reduction_text: 35_to_1
    reference_bearing: '6808'
    rotor_thickness: 5.0
    run_scad: false
    run_solidcraft: true
    shaft_radius_name: m5
    split_output_casing: true
    style: version_9
    taxonomy_1: oobb
    taxonomy_2: part
    taxonomy_3: motor_gearbox
    taxonomy_4: cycloidal
    taxonomy_5: version_9
    taxonomy_6: 35_to_1_reduction
oomlout_ai_roboclick_1:
    actions:
    -   command: text_jinja_template
        convert_to_pdf: false
        convert_to_png: false
        dict_data:
            architecture: simple_6810
            automatic_pitch: 1
            bearing_eccentric_bottom: '6702'
            bearing_eccentric_top: '6702'
            casing_wall: 2.0
            direct_stack_layout: base_grub
            directory: parts\oobb_part_motor_gearbox_cycloidal_version_9_35_to_1_reduction
            disc_gap: 0.5
            drive_connection: grub_nut
            guide_bolt_radius_name: m3
            guide_pin_count: 6
            guide_pin_diameter: 3.0
            guide_pin_pitch_radius: 15.0
            lobe_clearance: 0.2
            lobe_eccentricity_ratio: 0.9
            lobe_radius: 1.5
            motor_hole_pitch: 31
            motor_screw_length: 6
            name: oobb_part_motor_gearbox_cycloidal_version_9_35_to_1_reduction
            name_proper: Oobb Part Motor Gearbox Cycloidal Version 9 35 To 1 Reduction
            name_space: oobb part motor gearbox cycloidal version 9 35 to 1 reduction
            name_upper: OOBB PART MOTOR GEARBOX CYCLOIDAL VERSION 9 35 TO 1 REDUCTION
            native_parameters:
                automatic_internal_positions: '1'
                bottom_bearing: '6702'
                casing_bearing: '6808'
                contact_radius: 1.5 mm
                eccentricity: 0.7 mm
                guide_count: '6'
                guide_outer_radius: 1.5 mm
                guide_radius: 1.5 mm
                guide_screw_length: 25 mm
                reduction: '35'
                standoff_radius: 2.7 mm
                top_bearing: '6702'
            oobb_details:
                architecture: simple_6810
                automatic_pitch: 1
                bearing_eccentric_bottom: '6702'
                bearing_eccentric_top: '6702'
                casing_wall: 2.0
                direct_stack_layout: base_grub
                disc_gap: 0.5
                drive_connection: grub_nut
                guide_bolt_radius_name: m3
                guide_pin_count: 6
                guide_pin_diameter: 3.0
                guide_pin_pitch_radius: 15.0
                lobe_clearance: 0.2
                lobe_eccentricity_ratio: 0.9
                lobe_radius: 1.5
                motor_hole_pitch: 31
                motor_screw_length: 6
                native_parameters:
                    automatic_internal_positions: '1'
                    bottom_bearing: '6702'
                    casing_bearing: '6808'
                    contact_radius: 1.5 mm
                    eccentricity: 0.7 mm
                    guide_count: '6'
                    guide_outer_radius: 1.5 mm
                    guide_radius: 1.5 mm
                    guide_screw_length: 25 mm
                    reduction: '35'
                    standoff_radius: 2.7 mm
                    top_bearing: '6702'
                oobb_name: version_9
                oobb_type: cycloidal
                pitch_radius: 27.9
                pitch_radius_buffer: 0.0
                pitch_radius_increment: 0.05
                post_fasteners: true
                post_pitch_radius: 16.15
                post_radius: 2.7
                radius_offset: 0.7
                reduction: 35
                reduction_text: 35_to_1
                reference_bearing: '6808'
                rotor_thickness: 5.0
                run_scad: false
                run_solidcraft: true
                shaft_radius_name: m5
                split_output_casing: true
                style: version_9
                taxonomy_1: oobb
                taxonomy_2: part
                taxonomy_3: motor_gearbox
                taxonomy_4: cycloidal
                taxonomy_5: version_9
                taxonomy_6: 35_to_1_reduction
            pitch_radius: 27.9
            pitch_radius_buffer: 0.0
            pitch_radius_increment: 0.05
            post_fasteners: true
            post_pitch_radius: 16.15
            post_radius: 2.7
            radius_offset: 0.7
            reduction: 35
            reduction_text: 35_to_1
            reference_bearing: '6808'
            rotor_thickness: 5.0
            shaft_radius_name: m5
            split_output_casing: true
            style: version_9
            taxonomy_1: oobb
            taxonomy_10: ''
            taxonomy_11: ''
            taxonomy_12: ''
            taxonomy_13: ''
            taxonomy_14: ''
            taxonomy_15: ''
            taxonomy_2: part
            taxonomy_3: motor_gearbox
            taxonomy_4: cycloidal
            taxonomy_5: version_9
            taxonomy_6: 35_to_1_reduction
            taxonomy_7: ''
            taxonomy_8: ''
            taxonomy_9: ''
            url_chat: ''
        dict_data_files: {}
        dict_data_files_exists: {}
        file_output: label_oomp.svg
        file_template: C:\gh\oomlout_oobb_part_motor_gearbox_cycloidal_version_5\source_file\template_jinja\template_jinja_label_oomlout_76_2_mm_50_8_mm\working.svg.j2
        search_and_replace: []
    file_test: label_oomp.pdf
    retries_until_complete: 0
oomp_key: oomp_oobb_part_motor_gearbox_cycloidal_version_9_35_to_1_reduction
part_filter: oobb_part_motor_gearbox_cycloidal_version_9_35_to_1_reduction
pitch_radius: 27.9
pitch_radius_buffer: 0.0
pitch_radius_increment: 0.05
post_fasteners: true
post_pitch_radius: 16.15
post_radius: 2.7
radius_offset: 0.7
reduction: 35
reduction_text: 35_to_1
reference_bearing: '6808'
rotor_thickness: 5.0
shaft_radius_name: m5
split_output_casing: true
style: version_9
taxonomy_1: oobb
taxonomy_10: ''
taxonomy_11: ''
taxonomy_12: ''
taxonomy_13: ''
taxonomy_14: ''
taxonomy_15: ''
taxonomy_1_capital: Oobb
taxonomy_1_first_letter: o
taxonomy_1_first_letter_upper: O
taxonomy_1_length_1: o
taxonomy_1_length_2: oo
taxonomy_1_length_3: oob
taxonomy_1_length_4: oobb
taxonomy_1_length_5: oobb
taxonomy_1_upper: OOBB
taxonomy_1_upper_length_1: O
taxonomy_1_upper_length_2: OO
taxonomy_1_upper_length_3: OOB
taxonomy_1_upper_length_4: OOBB
taxonomy_1_upper_length_5: OOBB
taxonomy_2: part
taxonomy_2_capital: Part
taxonomy_2_first_letter: p
taxonomy_2_first_letter_upper: P
taxonomy_2_length_1: p
taxonomy_2_length_2: pa
taxonomy_2_length_3: par
taxonomy_2_length_4: part
taxonomy_2_length_5: part
taxonomy_2_upper: PART
taxonomy_2_upper_length_1: P
taxonomy_2_upper_length_2: PA
taxonomy_2_upper_length_3: PAR
taxonomy_2_upper_length_4: PART
taxonomy_2_upper_length_5: PART
taxonomy_3: motor_gearbox
taxonomy_3_capital: Motor Gearbox
taxonomy_3_first_letter: m
taxonomy_3_first_letter_upper: M
taxonomy_3_length_1: m
taxonomy_3_length_2: mo
taxonomy_3_length_3: mot
taxonomy_3_length_4: moto
taxonomy_3_length_5: motor
taxonomy_3_upper: MOTOR_GEARBOX
taxonomy_3_upper_length_1: M
taxonomy_3_upper_length_2: MO
taxonomy_3_upper_length_3: MOT
taxonomy_3_upper_length_4: MOTO
taxonomy_3_upper_length_5: MOTOR
taxonomy_4: cycloidal
taxonomy_4_capital: Cycloidal
taxonomy_4_first_letter: c
taxonomy_4_first_letter_upper: C
taxonomy_4_length_1: c
taxonomy_4_length_2: cy
taxonomy_4_length_3: cyc
taxonomy_4_length_4: cycl
taxonomy_4_length_5: cyclo
taxonomy_4_upper: CYCLOIDAL
taxonomy_4_upper_length_1: C
taxonomy_4_upper_length_2: CY
taxonomy_4_upper_length_3: CYC
taxonomy_4_upper_length_4: CYCL
taxonomy_4_upper_length_5: CYCLO
taxonomy_5: version_9
taxonomy_5_capital: Version 9
taxonomy_5_first_letter: v
taxonomy_5_first_letter_upper: V
taxonomy_5_length_1: v
taxonomy_5_length_2: ve
taxonomy_5_length_3: ver
taxonomy_5_length_4: vers
taxonomy_5_length_5: versi
taxonomy_5_upper: VERSION_9
taxonomy_5_upper_length_1: V
taxonomy_5_upper_length_2: VE
taxonomy_5_upper_length_3: VER
taxonomy_5_upper_length_4: VERS
taxonomy_5_upper_length_5: VERSI
taxonomy_6: 35_to_1_reduction
taxonomy_6_capital: 35 To 1 Reduction
taxonomy_6_first_letter: '3'
taxonomy_6_first_letter_upper: '3'
taxonomy_6_length_1: '3'
taxonomy_6_length_2: '35'
taxonomy_6_length_3: '35_'
taxonomy_6_length_4: 35_t
taxonomy_6_length_5: 35_to
taxonomy_6_upper: 35_TO_1_REDUCTION
taxonomy_6_upper_length_1: '3'
taxonomy_6_upper_length_2: '35'
taxonomy_6_upper_length_3: '35_'
taxonomy_6_upper_length_4: 35_T
taxonomy_6_upper_length_5: 35_TO
taxonomy_7: ''
taxonomy_8: ''
taxonomy_9: ''
url_chat: ''
