oomlout/oomlout_oobb_part_motor_gearbox_cycloidal_version_5/parts/oobb_part_motor_gearbox_cycloidal_version_6_20_to_1_reduction_configuration_3d9262f6/working.yaml

architecture: simple_6810
automatic_pitch: 1
bearing_eccentric_bottom: '6703'
bearing_eccentric_top: '6703'
bip_39_2_word_array:
- swallow
- father
bip_39_2_word_no_space: swallowfather
bip_39_2_word_space: swallow father
bip_39_2_word_underscore: swallow_father
bip_39_3_word_array:
- swallow
- father
- total
bip_39_3_word_no_space: swallowfathertotal
bip_39_3_word_space: swallow father total
bip_39_3_word_underscore: swallow_father_total
bip_39_full_array:
- swallow
- father
- total
- imitate
- exclude
- sea
- ethics
- pride
- erase
- suspect
- throw
- vicious
bip_39_full_no_space: swallowfathertotalimitateexcludeseaethicsprideerasesuspectthrowvicious
bip_39_full_space: swallow father total imitate exclude sea ethics pride erase suspect
    throw vicious
bip_39_full_underscore: swallow_father_total_imitate_exclude_sea_ethics_pride_erase_suspect_throw_vicious
casing_wall: 2.0
direct_stack_layout: base_grub
directory: parts/oobb_part_motor_gearbox_cycloidal_version_6_20_to_1_reduction_configuration_3d9262f6
disc_gap: 0.5
drive_connection: grub_nut
guide_bolt_radius_name: m3
guide_pin_count: 6
guide_pin_diameter: 3.0
guide_pin_pitch_radius: 17.4
id: oobb_part_motor_gearbox_cycloidal_version_6_20_to_1_reduction_configuration_3d9262f6
id_no_class: oobb_part_motor_gearbox_cycloidal_version_6_20_to_1_reduction_configuration_3d9262f6
id_no_size: oobb_part_motor_gearbox_cycloidal_version_6_20_to_1_reduction_configuration_3d9262f6
id_no_type: oobb_part_motor_gearbox_cycloidal_version_6_20_to_1_reduction_configuration_3d9262f6
link_github: https://github.com/oomlout/oomlout_oomp_version_1_messy/tree/main/parts/oobb_part_motor_gearbox_cycloidal_version_6_20_to_1_reduction_configuration_3d9262f6
link_main: https://github.com/oomlout/oomlout_oomp_version_1_messy/tree/main/parts/oobb_part_motor_gearbox_cycloidal_version_6_20_to_1_reduction_configuration_3d9262f6
link_redirect: https://github.com/oomlout/oomlout_oomp_version_1_messy/tree/main/parts/oobb_part_motor_gearbox_cycloidal_version_6_20_to_1_reduction_configuration_3d9262f6
lobe_clearance: 0.2
lobe_eccentricity_ratio: 0.9
lobe_radius: 3.0
md5: db0a779738b4ef83d36d544c7b5b8579
md5_10: db0a779738
md5_10_upper: DB0A779738
md5_5: db0a7
md5_5_upper: DB0A7
md5_6: db0a77
md5_6_alpha: 8jofr
md5_6_alpha_upper: 8JOFR
md5_6_upper: DB0A77
motor_hole_pitch: 31
motor_screw_length: 6
name: Oobb Part Motor Gearbox Cycloidal Version 6 20 To 1 Reduction Configuration
    3D9262F6
name_no_class: Oobb Part Motor Gearbox Cycloidal Version 6 20 To 1 Reduction Configuration
    3D9262F6
name_no_size: Oobb Part Motor Gearbox Cycloidal Version 6 20 To 1 Reduction Configuration
    3D9262F6
name_no_type: Oobb Part Motor Gearbox Cycloidal Version 6 20 To 1 Reduction Configuration
    3D9262F6
name_proper: Oobb Part Motor Gearbox Cycloidal Version 6 20 To 1 Reduction Configuration
    3D9262F6
name_space: oobb part motor gearbox cycloidal version 6 20 to 1 reduction configuration
    3d9262f6
name_upper: OOBB PART MOTOR GEARBOX CYCLOIDAL VERSION 6 20 TO 1 REDUCTION CONFIGURATION
    3D9262F6
oobb_details:
    architecture: simple_6810
    automatic_pitch: 1
    bearing_eccentric_bottom: '6703'
    bearing_eccentric_top: '6703'
    casing_wall: 2.0
    direct_stack_layout: base_grub
    disc_gap: 0.5
    drive_connection: grub_nut
    guide_bolt_radius_name: m3
    guide_pin_count: 6
    guide_pin_diameter: 3.0
    guide_pin_pitch_radius: 17.4
    lobe_clearance: 0.2
    lobe_eccentricity_ratio: 0.9
    lobe_radius: 3.0
    motor_hole_pitch: 31
    motor_screw_length: 6
    oobb_name: version_6
    oobb_type: cycloidal
    pitch_radius: 31.15
    pitch_radius_buffer: 0.0
    pitch_radius_increment: 0.05
    post_fasteners: true
    post_pitch_radius: 18.55
    post_radius: 2.7
    radius_offset: 1.4
    reduction: 20
    reduction_text: 20_to_1
    reference_bearing: '6810'
    rotor_thickness: 5.0
    run_scad: false
    run_solidcraft: true
    shaft_radius_name: m5
    split_output_casing: true
    style: version_6
    taxonomy_1: oobb
    taxonomy_2: part
    taxonomy_3: motor_gearbox
    taxonomy_4: cycloidal
    taxonomy_5: version_6
    taxonomy_6: 20_to_1_reduction
    taxonomy_7: configuration_3d9262f6
oomlout_ai_roboclick_1:
    actions:
    -   command: text_jinja_template
        convert_to_pdf: false
        convert_to_png: false
        dict_data:
            architecture: simple_6810
            automatic_pitch: 1
            bearing_eccentric_bottom: '6703'
            bearing_eccentric_top: '6703'
            casing_wall: 2.0
            direct_stack_layout: base_grub
            directory: parts\oobb_part_motor_gearbox_cycloidal_version_6_20_to_1_reduction_configuration_3d9262f6
            disc_gap: 0.5
            drive_connection: grub_nut
            guide_bolt_radius_name: m3
            guide_pin_count: 6
            guide_pin_diameter: 3.0
            guide_pin_pitch_radius: 17.4
            lobe_clearance: 0.2
            lobe_eccentricity_ratio: 0.9
            lobe_radius: 3.0
            motor_hole_pitch: 31
            motor_screw_length: 6
            name: oobb_part_motor_gearbox_cycloidal_version_6_20_to_1_reduction_configuration_3d9262f6
            name_proper: Oobb Part Motor Gearbox Cycloidal Version 6 20 To 1 Reduction
                Configuration 3D9262F6
            name_space: oobb part motor gearbox cycloidal version 6 20 to 1 reduction
                configuration 3d9262f6
            name_upper: OOBB PART MOTOR GEARBOX CYCLOIDAL VERSION 6 20 TO 1 REDUCTION
                CONFIGURATION 3D9262F6
            oobb_details:
                architecture: simple_6810
                automatic_pitch: 1
                bearing_eccentric_bottom: '6703'
                bearing_eccentric_top: '6703'
                casing_wall: 2.0
                direct_stack_layout: base_grub
                disc_gap: 0.5
                drive_connection: grub_nut
                guide_bolt_radius_name: m3
                guide_pin_count: 6
                guide_pin_diameter: 3.0
                guide_pin_pitch_radius: 17.4
                lobe_clearance: 0.2
                lobe_eccentricity_ratio: 0.9
                lobe_radius: 3.0
                motor_hole_pitch: 31
                motor_screw_length: 6
                oobb_name: version_6
                oobb_type: cycloidal
                pitch_radius: 31.15
                pitch_radius_buffer: 0.0
                pitch_radius_increment: 0.05
                post_fasteners: true
                post_pitch_radius: 18.55
                post_radius: 2.7
                radius_offset: 1.4
                reduction: 20
                reduction_text: 20_to_1
                reference_bearing: '6810'
                rotor_thickness: 5.0
                run_scad: false
                run_solidcraft: true
                shaft_radius_name: m5
                split_output_casing: true
                style: version_6
                taxonomy_1: oobb
                taxonomy_2: part
                taxonomy_3: motor_gearbox
                taxonomy_4: cycloidal
                taxonomy_5: version_6
                taxonomy_6: 20_to_1_reduction
                taxonomy_7: configuration_3d9262f6
            pitch_radius: 31.15
            pitch_radius_buffer: 0.0
            pitch_radius_increment: 0.05
            post_fasteners: true
            post_pitch_radius: 18.55
            post_radius: 2.7
            radius_offset: 1.4
            reduction: 20
            reduction_text: 20_to_1
            reference_bearing: '6810'
            rotor_thickness: 5.0
            shaft_radius_name: m5
            split_output_casing: true
            style: version_6
            taxonomy_1: oobb
            taxonomy_10: ''
            taxonomy_11: ''
            taxonomy_12: ''
            taxonomy_13: ''
            taxonomy_14: ''
            taxonomy_15: ''
            taxonomy_2: part
            taxonomy_3: motor_gearbox
            taxonomy_4: cycloidal
            taxonomy_5: version_6
            taxonomy_6: 20_to_1_reduction
            taxonomy_7: configuration_3d9262f6
            taxonomy_8: ''
            taxonomy_9: ''
            url_chat: ''
        dict_data_files: {}
        dict_data_files_exists: {}
        file_output: label_oomp.svg
        file_template: C:\gh\oomlout_oobb_part_motor_gearbox_cycloidal_version_5\source_file\template_jinja\template_jinja_label_oomlout_76_2_mm_50_8_mm\working.svg.j2
        search_and_replace: []
    file_test: label_oomp.pdf
    retries_until_complete: 0
oomp_key: oomp_oobb_part_motor_gearbox_cycloidal_version_6_20_to_1_reduction_configuration_3d9262f6
part_filter: oobb_part_motor_gearbox_cycloidal_version_6_20_to_1_reduction_configuration_3d9262f6
pitch_radius: 31.15
pitch_radius_buffer: 0.0
pitch_radius_increment: 0.05
post_fasteners: true
post_pitch_radius: 18.55
post_radius: 2.7
radius_offset: 1.4
reduction: 20
reduction_text: 20_to_1
reference_bearing: '6810'
rotor_thickness: 5.0
shaft_radius_name: m5
split_output_casing: true
style: version_6
taxonomy_1: oobb
taxonomy_10: ''
taxonomy_11: ''
taxonomy_12: ''
taxonomy_13: ''
taxonomy_14: ''
taxonomy_15: ''
taxonomy_1_capital: Oobb
taxonomy_1_first_letter: o
taxonomy_1_first_letter_upper: O
taxonomy_1_length_1: o
taxonomy_1_length_2: oo
taxonomy_1_length_3: oob
taxonomy_1_length_4: oobb
taxonomy_1_length_5: oobb
taxonomy_1_upper: OOBB
taxonomy_1_upper_length_1: O
taxonomy_1_upper_length_2: OO
taxonomy_1_upper_length_3: OOB
taxonomy_1_upper_length_4: OOBB
taxonomy_1_upper_length_5: OOBB
taxonomy_2: part
taxonomy_2_capital: Part
taxonomy_2_first_letter: p
taxonomy_2_first_letter_upper: P
taxonomy_2_length_1: p
taxonomy_2_length_2: pa
taxonomy_2_length_3: par
taxonomy_2_length_4: part
taxonomy_2_length_5: part
taxonomy_2_upper: PART
taxonomy_2_upper_length_1: P
taxonomy_2_upper_length_2: PA
taxonomy_2_upper_length_3: PAR
taxonomy_2_upper_length_4: PART
taxonomy_2_upper_length_5: PART
taxonomy_3: motor_gearbox
taxonomy_3_capital: Motor Gearbox
taxonomy_3_first_letter: m
taxonomy_3_first_letter_upper: M
taxonomy_3_length_1: m
taxonomy_3_length_2: mo
taxonomy_3_length_3: mot
taxonomy_3_length_4: moto
taxonomy_3_length_5: motor
taxonomy_3_upper: MOTOR_GEARBOX
taxonomy_3_upper_length_1: M
taxonomy_3_upper_length_2: MO
taxonomy_3_upper_length_3: MOT
taxonomy_3_upper_length_4: MOTO
taxonomy_3_upper_length_5: MOTOR
taxonomy_4: cycloidal
taxonomy_4_capital: Cycloidal
taxonomy_4_first_letter: c
taxonomy_4_first_letter_upper: C
taxonomy_4_length_1: c
taxonomy_4_length_2: cy
taxonomy_4_length_3: cyc
taxonomy_4_length_4: cycl
taxonomy_4_length_5: cyclo
taxonomy_4_upper: CYCLOIDAL
taxonomy_4_upper_length_1: C
taxonomy_4_upper_length_2: CY
taxonomy_4_upper_length_3: CYC
taxonomy_4_upper_length_4: CYCL
taxonomy_4_upper_length_5: CYCLO
taxonomy_5: version_6
taxonomy_5_capital: Version 6
taxonomy_5_first_letter: v
taxonomy_5_first_letter_upper: V
taxonomy_5_length_1: v
taxonomy_5_length_2: ve
taxonomy_5_length_3: ver
taxonomy_5_length_4: vers
taxonomy_5_length_5: versi
taxonomy_5_upper: VERSION_6
taxonomy_5_upper_length_1: V
taxonomy_5_upper_length_2: VE
taxonomy_5_upper_length_3: VER
taxonomy_5_upper_length_4: VERS
taxonomy_5_upper_length_5: VERSI
taxonomy_6: 20_to_1_reduction
taxonomy_6_capital: 20 To 1 Reduction
taxonomy_6_first_letter: '2'
taxonomy_6_first_letter_upper: '2'
taxonomy_6_length_1: '2'
taxonomy_6_length_2: '20'
taxonomy_6_length_3: '20_'
taxonomy_6_length_4: 20_t
taxonomy_6_length_5: 20_to
taxonomy_6_upper: 20_TO_1_REDUCTION
taxonomy_6_upper_length_1: '2'
taxonomy_6_upper_length_2: '20'
taxonomy_6_upper_length_3: '20_'
taxonomy_6_upper_length_4: 20_T
taxonomy_6_upper_length_5: 20_TO
taxonomy_7: configuration_3d9262f6
taxonomy_7_capital: Configuration 3D9262F6
taxonomy_7_first_letter: c
taxonomy_7_first_letter_upper: C
taxonomy_7_length_1: c
taxonomy_7_length_2: co
taxonomy_7_length_3: con
taxonomy_7_length_4: conf
taxonomy_7_length_5: confi
taxonomy_7_upper: CONFIGURATION_3D9262F6
taxonomy_7_upper_length_1: C
taxonomy_7_upper_length_2: CO
taxonomy_7_upper_length_3: CON
taxonomy_7_upper_length_4: CONF
taxonomy_7_upper_length_5: CONFI
taxonomy_8: ''
taxonomy_9: ''
url_chat: ''
