oomlout/oomlout_oobb_part_motor_gearbox_cycloidal_version_5/gearbox_native/captured_defaults.yaml

architecture: captured_6810
radius_offset: 1.85
lobe_radius: 2.1
bearing_eccentric: '6704'
bearing_shaft: '6704'
bearing_output: '6810'
bearing_guide: '6700'
guide_pin_pitch_radius: 21.1
allow_shared_bearing_pockets: true
bearing_outer_race_gap_min: 0.05
flange_depth: 17.0
flange_web: 6.5
coupling_screw_length: 12.0
rotor_thickness: 7.0
disc_gap: 0.5
disc_join_radius: 30.0
disc_join_count: 3
disc_join_phase: 60
disc_join_length: 6.0
disc_join_nut_depth: 2.4
guide_lip_radius: 7.0
eccentric_lip_radius: 12.7
housing_lug_radius: 7.0
case_cover_post_radius: 4.8
case_cover_post_clearance: 0.2
case_cover_post_floor: 2.5
housing_screw_style: socket_cap
housing_screw_max_length: 35.0
deck_bottom: 14.0
deck_radius: 34.0
deck_bore: 13.7
deck_screw_radius: 16.5
deck_screw_head_z: 26.0
deck_screw_length: 25.0
post_pitch_radius: 29.0
post_radius: 3.0
post_clearance: 0.15
post_screw_length: 25.0
post_nut_bottom: 27.0
drive_flange_radius: 13.5
drive_flange_depth: 8.5
hub_key_radius: 4.9
hub_key_flat: 4.3
hub_key_depth: 2.0
hub_key_clearance: 0.15
hub_bolt_length: 35.0
hub_bolt_radius_name: m6
hub_nut_bottom: 24.2
collar_bottom: 16.0
guide_bolt_length: 40.0
guide_nut_bottom: 14.2
front_hub_screw_length: 16.0
animation_explode: 12
animation_camera_distance: 1600
animation_size:
- 960
- 1600
print_width: 240
