oomlout/oomlout_oobb_part_motor_gearbox_cycloidal_version_5/gearbox_native/common_defaults.yaml

reduction: 20
radius_offset: 1.75
lobe_radius: 2.0
lobe_eccentricity_ratio: 0.91
bearing_eccentric: '6706'
bearing_shaft: '6706'
bearing_output: '6814'
bearing_guide: MR106
guide_bolt_radius_name: m6
guide_spacer_radius: 3.425
guide_spacer_bore: 3.1
guide_head_depth: 4.0
guide_head_clearance: 0.2
rotor_thickness: 7.0
disc_gap: 0.5
axial_clearance: 0.5
flange_depth: 13.0
flange_web: 2.0
guide_pin_diameter: 6.0
guide_pin_pitch_radius: 27.95
guide_head_wall: 1.0
guide_pin_count: 6
guide_pin_clearance: 0.15
bearing_seat_clearance: 0.1
bearing_endplay: 0.1
journal_clearance: 0.1
lobe_clearance: 0.2
minimum_wall: 2.0
motor_plate_depth: 4.0
motor_hole_pitch: 31.0
motor_pilot_diameter: 22.0
motor_pilot_clearance: 0.2
motor_shaft_length: 24.0
motor_body_depth: 40.0
motor_screw_length: 6.0
shaft_radius_name: m5
coupling_diameter: 22.0
coupling_barrel_diameter: 10.0
coupling_length: 12.0
coupling_barrel_length: 10.0
coupling_pitch_diameter: 16.0
coupling_flange_hole_diameter: 3.0
coupling_face_clearance: 0.2
motor_pilot_height: 2.0
coupling_grub_from_barrel_top: 5.0
coupling_grub_angles:
- 45
- 135
coupling_service_angle: 0.0
coupling_screw_length: 10.0
coupling_nut_rotation_offset: 180.0
coupling_nut_hex_rotation: 30.0
coupling_nut_side_clearance: 0.1
drive_roof_depth: 2.0
drive_flange_clearance: 0.2
drive_cavity_clearance: 0.3
rear_bearing_lift: 0.3
casing_bottom_clearance: 0.5
case_nut_plate_clearance: 3.0
grub_access_radius: 1.7
samples_per_lobe: 48
profile_tolerance: 0.005
front_retainer_depth: 2.0
rotor_central_wall: 1.5
motor_body_width: 42.0
motor_body_clearance: 0.4
guide_thread_allowance: 18.0
