oomlout/oomlout_oobb_part_motor_gearbox_cycloidal_version_5/(commit log)

2026-10-28 Add native parametric V7 gearbox and preserve sealed releases
    [3dpr.scad, 3dpr.step, 3dpr.stl, 3dpr_solidcraft.stl, animation.scad, assembly.scad, bearing_eccentric.stl, bearing_guide.stl]
2026-10-28 Make casing bearings configurable and snap tabs to odd OOBB footprints
    [eccentric_hub_lower.step, eccentric_hub_upper.step, motor_mount.step, output_casing_lower.step, output_casing_upper.step, pin_front.step, rotor_a.step, rotor_b.step]
2026-10-29 Seal V7 and publish parametric V8 three-piece gearbox presets
    [3dpr.step, 3dpr.stl, 3dpr_solidcraft.stl, eccentric_hub_lower.step, eccentric_hub_lower.stl, eccentric_hub_upper.step, eccentric_hub_upper.stl, exploded.step]
2026-10-29 Seal V8 and develop 35:1 native V9 gearbox in 5x5 OOBB footprint
    [3dpr.step, 3dpr.stl, 3dpr_solidcraft.stl, eccentric_hub_lower.step, eccentric_hub_lower.stl, eccentric_hub_upper.step, eccentric_hub_upper.stl, exploded.step]
